MakeACS/HW-NFC-Core/README.md

# NFC Core

This is the repository for the firmware, hardware, mechanical components, and documentation of the NFC Core of the ACS hardware. 

This is also the centralized repository for hardware, firmware, and documentation used by other variants of the Core, such as the [RFID Core](https://github.com/MakeACS/HW-RFID-Core). 

## License
This project is licensed under the CERN-OHL-S 2.0 License. See LIECENSE.txt for more information.
