MakeACS/HW-NFC-Core/Mechanical/README.md

# Mechanical

This section of the repository contains 3D CAD, BOM, assembly instructions, etc. for all non-electrical hardware and mechanical components. 

Autodesk Fusion .f3z files will contain the most recent work, with outjob files (STEP, STL, BOM, etc.) being generated on major releases.
