MakeACS/HW-NFC-Core/Hardware/README.md

# Hardware

This section of the repository contains information relating to component-level electrical hardware. 

In-progress work can be found in the EasyEDA Pro .eprj2 files, with outjob files (PDF schematic, Gerber, BOM, etc.) being generated for the most recent version.
