MakeACS/HW-NFC-Core/Documentation/.Overview.md

# NFC Core Documentation

This is the documentation for the NFC Core. This cocumentation is meant to be used for technical development and construction of the device, and may not be pertinent to end-users.
