MakeACS/HW-NFC-Core/Documentation/docs/For Developers/Firmware/index.md

# Firmware Overview

Firmware for the MakeACS Core is written in C++ with usage of the Arduino Framework for ease-of-reading and ease-of-modification by users with minimal coding experience. 

Firmware is developed and compiled in the [PIOArduino](https://github.com/pioarduino) environment, to allow for hardware variants and build-on-deploy in GitHub Actions.
