MakeACS/HW-NFC-Core/Hardware/Outjob/BOM_V3.1.0 NFC Card Reader Core_NFC Card Reader PCB_2026-11-07.xlsx

No. | Quantity | Device | Designator | Footprint | Value | Manufacturer Part | Manufacturer | Supplier Part | Supplier | LCSC Price | JLCPCB Part Class
1 | 1 | MLT-8540 | BZR1 | BUZ-SMD_4P-L8.5-W8.5-P8.50-TL | 2.7kHz | MLT-8540 | 华能 | C95300 | LCSC |  | Extended Part
2 | 2 | CL10C120JB8NNNC | C1,C7 | C0603 | 12pF | CL10C120JB8NNNC | SAMSUNG(三星) | C38523 | LCSC |  | Basic Part
3 | 2 | CL10B474KA8NNNC | C2,C4 | C0603 | 470nF | CL10B474KA8NNNC | SAMSUNG(三星) | C1623 | LCSC |  | Basic Part
4 | 41 | CC0603KRX7R9BB104 | C3,C6,C8,C13,C14,C15,C16,C23,C24,C26,C27,C31,C32,C33,C34,C35,C36,C39,C40,C43,C44,C53,C59,C64,C71,C73,C74,C76,C77,C78,C79,C80,C81,C93,C94,C95,C96,C97,C98,C102,C104 | C0603 | 100nF | CC0603KRX7R9BB104 | YAGEO(国巨) | C14663 | LCSC |  | Basic Part
5 | 6 | CL10A105KB8NNNC | C5,C22,C29,C60,C90,C101 | C0603 | 1uF | CL10A105KB8NNNC | SAMSUNG(三星) | C15849 | LCSC |  | Basic Part
6 | 2 | CL10B102KB8NNNC | C9,C20 | C0603 | 1nF | CL10B102KB8NNNC | SAMSUNG(三星) | C1588 | LCSC |  | Basic Part
7 | 2 | CL10C680JB8NNNC | C10,C19 | C0603 | 68pF | CL10C680JB8NNNC | SAMSUNG(三星) | C28262 | LCSC |  | Extended Part
8 | 4 | CL10C121JB8NNNC | C11,C12,C17,C18 | C0603 | 120pF | CL10C121JB8NNNC | SAMSUNG(三星) | C18438 | LCSC |  | Extended Part
9 | 4 | CL31A476MPHNNNE | C21,C41,C42,C55 | C1206 | 47uF | CL31A476MPHNNNE | SAMSUNG(三星) | C96123 | LCSC |  | Basic Part
10 | 4 | 0603B103K500NT | C25,C85,C87,C89 | C0603 | 10nF | 0603B103K500NT | FH(风华) | C57112 | LCSC |  | Basic Part
11 | 29 | CL10A106MA8NRNC | C28,C30,C37,C38,C45,C46,C47,C48,C49,C51,C52,C54,C56,C57,C61,C62,C63,C65,C66,C67,C68,C69,C72,C75,C91,C92,C99,C100,C103 | C0603 | 10uF | CL10A106MA8NRNC | SAMSUNG(三星) | C96446 | LCSC |  | Basic Part
12 | 1 | 0603CG300J500NT | C50 | C0603 | 30pF | 0603CG300J500NT | FH(风华) | C1658 | LCSC
13 | 2 | CL10B333KB8NNNC | C58,C70 | C0603 | 33nF | CL10B333KB8NNNC | SAMSUNG(三星) | C21117 | LCSC
14 | 2 | CL10C180JB8NNNC | C82,C88 | C0603 | 18pF | CL10C180JB8NNNC | SAMSUNG(三星) | C1647 | LCSC |  | Basic Part
15 | 2 | 0603B682K500NT | C83,C84 | C0603 | 6.8nF | 0603B682K500NT | FH(风华) | C1631 | LCSC |  | Basic Part
16 | 1 | CL10A475KO8NNNC | C86 | C0603 | 4.7uF | CL10A475KO8NNNC | SAMSUNG(三星) | C19666 | LCSC |  | Basic Part
17 | 1 | HC-GAP-ACF012-1T | CN2 | USB-C-SMD_HC-GAP-ACF012-1T-1 |  | HC-GAP-ACF012-1T | HCTL(华灿天禄) | C2894906 | LCSC
18 | 1 | DS1038-15FBNSiA74-0CC | CN3 | DSUB-TH_DS1038-15FBNSIA74-0CC |  | DS1038-15FBNSiA74-0CC | CONNFLY | C75754 | LCSC |  | Extended Part
19 | 1 | HC913129AE-907-A | CN4 | RJ45-TH_HC911102A-904-A |  | HC913129AE-907-A | HCTL(华灿天禄) | C5341218 | LCSC |  | Extended Part
20 | 3 | SRV05-4_C558418 | D1,D5,D9 | SOT-23-6_L2.9-W1.6-P0.95-LS2.8-BL |  | SRV05-4 | TECH PUBLIC(台舟) | C558418 | LCSC |  | Extended Part
21 | 1 | SMFJ12A | D2 | SOD-123F_L2.8-W1.8-LS3.7-RD |  | SMFJ12A | RUILON(瑞隆源) | C82280 | LCSC
22 | 3 | B5819W SL | D6,D7,D8 | SOD-123_L2.7-W1.6-LS3.7-RD-1 |  | B5819W SL | CJ(江苏长电/长晶) | C8598 | LCSC
23 | 3 | nSMD050-33V | F1,F2,F3 | F1206 |  | nSMD050-33V | 台湾陆海 | C70077 | LCSC |  | Extended Part
24 | 3 | JK-nSMD100-16_C369161 | F4,F5,F6 | F1206 |  | JK-nSMD100-16 | JK(金科) | C369161 | LCSC
25 | 2 | MH2029-300Y | FB1,FB2 | L0805 |  | MH2029-300Y | BOURNS | C840593 | LCSC |  | Extended Part
26 | 1 | DS1023-1x5SF11 | H1 | HDR-TH_5P-P2.54-V-F-B |  | DS1023-1x5SF11 | CONNFLY | C7509517 | LCSC |  | Extended Part
27 | 2 | MLP1608VR47DT0S1 | L1,L2 | L0603 | 470nH | MLP1608VR47DT0S1 | TDK | C105533 | LCSC
28 | 2 | PSPMAA0605H-4R7M-ANP | L3,L4 | IND-SMD_L7.1-W6.6 | 4.7uH | PSPMAA0605H-4R7M-ANP | PROD(谱罗德) | C2983090 | LCSC |  | Extended Part
29 | 1 | KT-0603R | LED1 | LED0603-RD |  | KT-0603R | KENTO | C2286 | LCSC
30 | 2 | WS2812D-F8 | LED2,LED3 | LED-TH_WS2812D-F8 |  | WS2812D-F8 | worldsemi | C139126 | LCSC
31 | 4 | SMTSO30100CTJ | M6,M7,M8,M9 | SCREW-SMD_BD5.6-D4.1-H10 |  | SMTSO30100CTJ | Sinhoo(雄和远景) | C2916370 | LCSC |  | Extended Part
32 | 4 | AO3400A | Q1,Q2,Q3,Q4 | SOT-23-3_L2.9-W1.6-P1.90-LS2.8-BR |  | AO3400A | AOS | C20917 | LCSC |  | Basic Part
33 | 22 | 0603WAF1002T5E | R1,R2,R19,R20,R21,R22,R25,R26,R27,R28,R30,R31,R35,R37,R40,R52,R53,R61,R62,R63,R65,R66 | R0603 | 10kΩ | 0603WAF1002T5E | UNI-ROYAL(厚声) | C25804 | LCSC |  | Basic Part
34 | 10 | 0603WAF1001T5E | R3,R10,R14,R24,R34,R42,R44,R47,R55,R64 | R0603 | 1kΩ | 0603WAF1001T5E | UNI-ROYAL(厚声) | C21190 | LCSC |  | Basic Part
35 | 7 | 0603WAF2202T5E | R4,R9,R29,R32,R33,R57,R58 | R0603 | 22kΩ | 0603WAF2202T5E | UNI-ROYAL(厚声) | C31850 | LCSC
36 | 2 | 0603WAF1003T5E | R5,R6 | R0603 | 100kΩ | 0603WAF1003T5E | UNI-ROYAL(厚声) | C25803 | LCSC |  | Basic Part
37 | 2 | 0603WAF510KT5E | R7,R8 | R0603 | 5.1Ω | 0603WAF510KT5E | UNI-ROYAL(厚声) | C25197 | LCSC |  | Basic Part
38 | 4 | 0805W8F100JT5E | R11,R23,R48,R49 | R0805_NEW | 10Ω | 0805W8F100JT5E | UNI-ROYAL(厚声) | C17415 | LCSC |  | Basic Part
39 | 2 | 0603WAF5101T5E | R12,R13 | R0603 | 5.1kΩ | 0603WAF5101T5E | UNI-ROYAL(厚声) | C23186 | LCSC
40 | 9 | 0603WAF4701T5E | R15,R16,R17,R18,R50,R51,R56,R59,R60 | R0603 | 4.7kΩ | 0603WAF4701T5E | UNI-ROYAL(厚声) | C23162 | LCSC |  | Basic Part
41 | 1 | RTT031242FTP | R36 | R0603 | 12.4kΩ | RTT031242FTP | RALEC(旺诠) | C103261 | LCSC |  | Extended Part
42 | 4 | RC0603DR-0749R9L | R38,R39,R45,R46 | R0603 | 49.9Ω | 0603WAF1002T5E | UNI-ROYAL(厚声) | C859049 | LCSC |  | Extended Part
43 | 1 | 0603WAF100JT5E | R41 | R0603 | 10Ω | 0603WAF100JT5E | UNI-ROYAL(厚声) | C22859 | LCSC |  | Basic Part
44 | 1 | 0603WAF1004T5E | R43 | R0603 | 1MΩ | 0603WAF1004T5E | UNI-ROYAL(厚声) | C22935 | LCSC |  | Basic Part
45 | 1 | 0603WAF750JT5E | R54 | R0603 | 75Ω | 0603WAF750JT5E | UNI-ROYAL(厚声) | C4275 | LCSC
46 | 2 | K9-1267F | SW1,SW2 | SW-TH_K9-1267F |  | K9-1267F | 韩国韩荣 | C107263 | LCSC |  | Extended Part
47 | 1 | TS-1045-A13B3-D2 | SW3 | SW-SMD_L7.5-W8.0-P4.50_TS-1045-A13B3-D2 |  | TS-1045-A13B3-D2 | Yuandi(元迪) | C557898 | LCSC |  | Extended Part
48 | 1 | MFRC63003HNE | U1 | HVQFN-32_L5.0-W5.0-P0.50-TL-EP3.1 |  | MFRC63003HNE | NXP(恩智浦) | C1526298 | LCSC |  | Extended Part
49 | 3 | SN74LVC1G17DBVR | U2,U3,U4 | SOT-23-5_L3.0-W1.7-P0.95-LS2.8-BR |  | SN74LVC1G17DBVR | TI(德州仪器) | C7836 | LCSC |  | Extended Part
50 | 1 | TMP112AIDRLR | U5 | SOT-563_L1.6-W1.2-P0.50-LS1.6-BR |  | TMP112AIDRLR | TI(德州仪器) | C28927 | LCSC |  | Extended Part
51 | 1 | LIS2DH12TR | U6 | LGA-12_L2.0-W2.0-P0.50-BL |  | LIS2DH12TR | ST(意法半导体) | C110926 | LCSC
52 | 2 | MX66100T | U7,U14 | SOT-23-6_L2.9-W1.6-P0.95-LS2.9-BL |  | MX66100T | Wuxi Maxinmicro(无锡明芯微) | C53121238 | LCSC |  | Extended Part
53 | 7 | SN74LXC1T45DBVR | U8,U9,U10,U11,U12,U20,U22 | SOT-23-6_L2.9-W1.6-P0.95-LS2.8-BL |  | SN74LXC1T45DBVR | TI(德州仪器) | C4364198 | LCSC |  | Extended Part
54 | 2 | TPS62933DRLR | U13,U15 | SOT-583-8_L2.1-W1.2-P0.50-LS1.6-BR |  | TPS62933DRLR | TI(德州仪器) | C3200405 | LCSC
55 | 1 | SN74AHC1G125DBVR | U16 | SOT-23-5_L3.0-W1.7-P0.95-LS2.8-BR |  | SN74AHC1G125DBVR | TI(德州仪器) | C7468 | LCSC |  | Extended Part
56 | 1 | W5500 | U17 | LQFP-48_L7.0-W7.0-P0.50-LS9.0-BL |  | W5500 | WIZNET | C32843 | LCSC |  | Extended Part
57 | 1 | ESP32-S3-MINI-1-N8 | U18 | BULETM-SMD_ESP32-S3-MINI-1-N8 | 2.4GHz | ESP32-S3-MINI-1-N8 | ESPRESSIF(乐鑫) | C2913206 | LCSC
58 | 1 | SN74LVC1T45DBVR | U19 | SOT-23-6_L2.9-W1.6-P0.95-LS2.8-BR |  | SN74LVC1T45DBVR | TI(德州仪器) | C7843 | LCSC
59 | 1 | THVD1424RGTR | U21 | VQFN-16_L3.0-W3.0-P0.50-TL-EP1.7 |  | THVD1424RGTR | TI(德州仪器) | C5359161 | LCSC |  | Extended Part
60 | 1 | X32252712MMB4SI | X1 | CRYSTAL-SMD_4P-L3.2-W2.5-BL-1 | 27.12MHz | X32252712MMB4SI | YXC(扬兴晶振) | C29975 | LCSC |  | Extended Part
61 | 1 | X322525MOB4SI | X2 | CRYSTAL-SMD_4P-L3.2-W2.5-BL | 25MHz | X322525MOB4SI | YXC(扬兴晶振) | C9006 | LCSC |  | Basic Part
