MakeACS/HW-NFC-Core/Firmware/build_output.txt

Processing esp32-s3-devkitm-1 (platform: https://github.com/pioarduino/platform-espressif32/releases/download/stable/platform-espressif32.zip; board: esp32-s3-devkitm-1; framework: arduino)
--------------------------------------------------------------------------------
Verbose mode can be enabled via `-v, --verbose` option
CONFIGURATION: https://docs.platformio.org/page/boards/espressif32/esp32-s3-devkitm-1.html
PLATFORM: Espressif 32 (55.3.311) > Espressif ESP32-S3-DevKitM-1
HARDWARE: ESP32S3 240MHz, 320KB RAM, 8MB Flash
DEBUG: Current (esp-builtin) On-board (esp-builtin) External (cmsis-dap, esp-bridge, esp-prog, esp-prog-2, iot-bus-jtag, jlink, minimodule, olimex-arm-usb-ocd, olimex-arm-usb-ocd-h, olimex-arm-usb-tiny-h, olimex-jtag-tiny, tumpa)
PACKAGES: 
 - contrib-piohome @ 3.4.4 
 - framework-arduinoespressif32 @ 3.3.11 
 - framework-arduinoespressif32-libs @ 5.5.5+sha.b774170ff46 
 - tool-esptoolpy @ 5.3.0 
 - tool-xtensa-esp-elf-gdb @ 17.1.0+20260402 
 - toolchain-xtensa-esp-elf @ 14.2.0+20260121
LDF: Library Dependency Finder -> https://bit.ly/configure-pio-ldf
LDF Modes: Finder ~ chain, Compatibility ~ soft
Found 56 compatible libraries
Scanning dependencies...
Dependency Graph
|-- OneWire @ 2.3.8
|-- ArduinoJson @ 7.4.3
|-- WebSockets @ 2.7.3
|-- ESP32Ping @ 1.7.0
|-- MQTTPubSubClient @ 0.3.2
|-- Adafruit NeoPixel @ 1.15.5
|-- SparkFun LIS2DH12 Arduino Library @ 1.0.3
|-- MFRC630 @ 0.0.0+20260815131936.sha.577b043
|-- ESP32Time @ 2.0.6
|-- FS @ 3.3.11
|-- HTTPClient @ 3.3.11
|-- Preferences @ 3.3.11
|-- SPI @ 3.3.11
|-- SPIFFS @ 3.3.11
|-- Update @ 3.3.11
|-- WiFi @ 3.3.11
|-- NetworkClientSecure @ 3.3.11
|-- Wire @ 3.3.11
|-- ESP32OTAPullSecure
Building in release mode
Compiling .pio\build\esp32-s3-devkitm-1\lib8f3\OneWire\OneWire.cpp.o
Compiling .pio\build\esp32-s3-devkitm-1\lib895\Network\NetworkClient.cpp.o
Compiling .pio\build\esp32-s3-devkitm-1\lib895\Network\NetworkEvents.cpp.o
Compiling .pio\build\esp32-s3-devkitm-1\lib895\Network\NetworkInterface.cpp.o
Compiling .pio\build\esp32-s3-devkitm-1\lib895\Network\NetworkManager.cpp.o
Compiling .pio\build\esp32-s3-devkitm-1\lib895\Network\NetworkServer.cpp.o
Compiling .pio\build\esp32-s3-devkitm-1\lib895\Network\NetworkUdp.cpp.o
Compiling .pio\build\esp32-s3-devkitm-1\lib3db\SPI\SPI.cpp.o
Compiling .pio\build\esp32-s3-devkitm-1\libfcb\Ethernet\ETH.cpp.o
Compiling .pio\build\esp32-s3-devkitm-1\lib93d\WiFi\AP.cpp.o
Compiling .pio\build\esp32-s3-devkitm-1\lib93d\WiFi\STA.cpp.o
Compiling .pio\build\esp32-s3-devkitm-1\lib93d\WiFi\WiFi.cpp.o
platformio.exe : .pio/libdeps/esp32-s3-devkitm-1/OneWire/OneWire.cpp:599:22: 
warning: extra tokens at end of #undef directive
At line:1 char:1
+ & "C:\Users\Jim\.platformio\penv\Scripts\platformio.exe" run > build_ ...
+ ~~~~~~~~~~~~~~~~~~~~~~~~~~~~~~~~~~~~~~~~~~~~~~~~~~~~~~~~~~~~~~~~~~~~~
    + CategoryInfo          : NotSpecified: (.pio/libdeps/es...undef directive 
   :String) [], RemoteException
    + FullyQualifiedErrorId : NativeCommandError
 
  599 | #  undef noInterrupts() {portMUX_TYPE mux = 
portMUX_INITIALIZER_UNLOCKED;portENTER_CRITICAL(&mux)
      |                      ^
.pio/libdeps/esp32-s3-devkitm-1/OneWire/OneWire.cpp:600:20: warning: extra 
tokens at end of #undef directive
  600 | #  undef interrupts() portEXIT_CRITICAL(&mux);}
      |                    ^
Compiling .pio\build\esp32-s3-devkitm-1\lib93d\WiFi\WiFiAP.cpp.o
Compiling .pio\build\esp32-s3-devkitm-1\lib93d\WiFi\WiFiGeneric.cpp.o
Compiling .pio\build\esp32-s3-devkitm-1\lib93d\WiFi\WiFiMulti.cpp.o
Compiling .pio\build\esp32-s3-devkitm-1\lib93d\WiFi\WiFiSTA.cpp.o
Compiling .pio\build\esp32-s3-devkitm-1\lib93d\WiFi\WiFiScan.cpp.o
Compiling .pio\build\esp32-s3-devkitm-1\libb79\NetworkClientSecure\NetworkClientSecure.cpp.o
Compiling .pio\build\esp32-s3-devkitm-1\libb79\NetworkClientSecure\ssl_client.cpp.o
Compiling .pio\build\esp32-s3-devkitm-1\lib9f8\WebSockets\SocketIOclient.cpp.o
Compiling .pio\build\esp32-s3-devkitm-1\lib9f8\WebSockets\WebSockets.cpp.o
Compiling .pio\build\esp32-s3-devkitm-1\lib9f8\WebSockets\WebSocketsClient.cpp.o
Compiling .pio\build\esp32-s3-devkitm-1\lib9f8\WebSockets\WebSocketsServer.cpp.o
Compiling .pio\build\esp32-s3-devkitm-1\lib9f8\WebSockets\libb64\cdecode.c.o
Compiling .pio\build\esp32-s3-devkitm-1\lib9f8\WebSockets\libb64\cencode.c.o
Compiling .pio\build\esp32-s3-devkitm-1\lib9f8\WebSockets\libsha1\libsha1.c.o
Compiling .pio\build\esp32-s3-devkitm-1\lib2e3\ESP32Ping\ESP32Ping.cpp.o
Compiling .pio\build\esp32-s3-devkitm-1\lib2e3\ESP32Ping\ping.cpp.o
Compiling .pio\build\esp32-s3-devkitm-1\lib079\MQTTPubSubClient\MQTTPubSubClient\lwmqtt\client.c.o
Compiling .pio\build\esp32-s3-devkitm-1\lib079\MQTTPubSubClient\MQTTPubSubClient\lwmqtt\helpers.c.o
Compiling .pio\build\esp32-s3-devkitm-1\lib079\MQTTPubSubClient\MQTTPubSubClient\lwmqtt\packet.c.o
Compiling .pio\build\esp32-s3-devkitm-1\lib079\MQTTPubSubClient\MQTTPubSubClient\lwmqtt\string.c.o
Compiling .pio\build\esp32-s3-devkitm-1\libb3f\Adafruit NeoPixel\Adafruit_NeoPixel.cpp.o
Compiling .pio\build\esp32-s3-devkitm-1\libb3f\Adafruit NeoPixel\Adafruit_Neopixel_RP2.cpp.o
Compiling .pio\build\esp32-s3-devkitm-1\libb3f\Adafruit NeoPixel\esp.c.o
Compiling .pio\build\esp32-s3-devkitm-1\libb3f\Adafruit NeoPixel\esp8266.c.o
Compiling .pio\build\esp32-s3-devkitm-1\libb3f\Adafruit NeoPixel\kendyte_k210.c.o
Compiling .pio\build\esp32-s3-devkitm-1\libb3f\Adafruit NeoPixel\psoc6.c.o
Compiling .pio\build\esp32-s3-devkitm-1\lib99b\Wire\Wire.cpp.o
Compiling .pio\build\esp32-s3-devkitm-1\libd86\SparkFun LIS2DH12 Arduino Library\SparkFun_LIS2DH12.cpp.o
Compiling .pio\build\esp32-s3-devkitm-1\libd86\SparkFun LIS2DH12 Arduino Library\lis2dh12_reg.cpp.o
Compiling .pio\build\esp32-s3-devkitm-1\lib93e\MFRC630\mfrc630.c.o
Compiling .pio\build\esp32-s3-devkitm-1\lib666\ESP32Time\ESP32Time.cpp.o
Compiling .pio\build\esp32-s3-devkitm-1\libfa4\FS\FS.cpp.o
Compiling .pio\build\esp32-s3-devkitm-1\libfa4\FS\vfs_api.cpp.o
Compiling .pio\build\esp32-s3-devkitm-1\lib588\HTTPClient\HTTPClient.cpp.o
Compiling .pio\build\esp32-s3-devkitm-1\lib68a\Preferences\Preferences.cpp.o
Compiling .pio\build\esp32-s3-devkitm-1\libe3a\SPIFFS\SPIFFS.cpp.o
Compiling .pio\build\esp32-s3-devkitm-1\lib681\Hash\PBKDF2_HMACBuilder.cpp.o
Compiling .pio\build\esp32-s3-devkitm-1\lib681\Hash\SHA1Builder.cpp.o
Compiling .pio\build\esp32-s3-devkitm-1\lib681\Hash\SHA2Builder.cpp.o
Compiling .pio\build\esp32-s3-devkitm-1\lib681\Hash\SHA3Builder.cpp.o
Compiling .pio\build\esp32-s3-devkitm-1\lib79a\Update\HttpsOTAUpdate.cpp.o
Compiling .pio\build\esp32-s3-devkitm-1\lib79a\Update\Updater.cpp.o
Compiling .pio\build\esp32-s3-devkitm-1\lib79a\Update\Updater_Signing.cpp.o
Compiling .pio\build\esp32-s3-devkitm-1\src\AudioVisualController.cpp.o
Compiling .pio\build\esp32-s3-devkitm-1\src\BusMonitor.cpp.o
Compiling .pio\build\esp32-s3-devkitm-1\src\DisplayController.cpp.o
Compiling .pio\build\esp32-s3-devkitm-1\src\MachineStateController.cpp.o
Compiling .pio\build\esp32-s3-devkitm-1\src\MainController.cpp.o
Building .pio\build\esp32-s3-devkitm-1\bootloader.bin
Generating partitions .pio\build\esp32-s3-devkitm-1\partitions.bin
esptool v5.3.0
Creating ESP32-S3 image...
Merged 2 ELF sections.
Successfully created ESP32-S3 image.
Compiling .pio\build\esp32-s3-devkitm-1\FrameworkArduino\ColorFormat.c.o
Compiling .pio\build\esp32-s3-devkitm-1\FrameworkArduino\Esp.cpp.o
Compiling .pio\build\esp32-s3-devkitm-1\FrameworkArduino\FirmwareMSC.cpp.o
Compiling .pio\build\esp32-s3-devkitm-1\FrameworkArduino\FunctionalInterrupt.cpp.o
Compiling .pio\build\esp32-s3-devkitm-1\FrameworkArduino\HEXBuilder.cpp.o
Compiling .pio\build\esp32-s3-devkitm-1\FrameworkArduino\HWCDC.cpp.o
Compiling .pio\build\esp32-s3-devkitm-1\FrameworkArduino\HardwareSerial.cpp.o
Compiling .pio\build\esp32-s3-devkitm-1\FrameworkArduino\HashBuilder.cpp.o
Compiling .pio\build\esp32-s3-devkitm-1\FrameworkArduino\IPAddress.cpp.o
Compiling .pio\build\esp32-s3-devkitm-1\FrameworkArduino\MD5Builder.cpp.o
Compiling .pio\build\esp32-s3-devkitm-1\FrameworkArduino\MacAddress.cpp.o
Compiling .pio\build\esp32-s3-devkitm-1\FrameworkArduino\Print.cpp.o
Compiling .pio\build\esp32-s3-devkitm-1\FrameworkArduino\Stream.cpp.o
Compiling .pio\build\esp32-s3-devkitm-1\FrameworkArduino\StreamString.cpp.o
Compiling .pio\build\esp32-s3-devkitm-1\FrameworkArduino\StringUtils.cpp.o
Compiling .pio\build\esp32-s3-devkitm-1\FrameworkArduino\Tone.cpp.o
Compiling .pio\build\esp32-s3-devkitm-1\FrameworkArduino\USB.cpp.o
Compiling .pio\build\esp32-s3-devkitm-1\FrameworkArduino\USBCDC.cpp.o
Compiling .pio\build\esp32-s3-devkitm-1\FrameworkArduino\USBMSC.cpp.o
src/MainController.cpp: In function 'void loop()':
src/MainController.cpp:642:70: warning: 'ArduinoJson::V743PB22::JsonObject 
ArduinoJson::V743PB22::JsonArray::createNestedObject() const' is deprecated: 
use add<JsonObject>() instead [-Wdeprecated-declarations]
  642 |             JsonObject stateObject = 
stateChannels.createNestedObject();
      |                                      ~~~~~~~~~~~~~~~~~~~~~~~~~~~~~~~~^~
In file included from 
.pio/libdeps/esp32-s3-devkitm-1/ArduinoJson/src/ArduinoJson.hpp:65,
                 from 
.pio/libdeps/esp32-s3-devkitm-1/ArduinoJson/src/ArduinoJson.h:9,
                 from src/Globals.h:5,
                 from src/MainController.cpp:16:
.pio/libdeps/esp32-s3-devkitm-1/ArduinoJson/src/ArduinoJson/compatibility.hpp:1
40:19: note: declared here
  140 | inline JsonObject JsonArray::createNestedObject() const {
      |                   ^~~~~~~~~
src/MainController.cpp:671:68: warning: 'ArduinoJson::V743PB22::JsonObject 
ArduinoJson::V743PB22::JsonArray::createNestedObject() const' is deprecated: 
use add<JsonObject>() instead [-Wdeprecated-declarations]
  671 |         JsonObject configObject = configChannels.createNestedObject();
      |                                   ~~~~~~~~~~~~~~~~~~~~~~~~~~~~~~~~~^~
.pio/libdeps/esp32-s3-devkitm-1/ArduinoJson/src/ArduinoJson/compatibility.hpp:1
40:19: note: declared here
  140 | inline JsonObject JsonArray::createNestedObject() const {
      |                   ^~~~~~~~~
src/MainController.cpp:681:67: warning: 'ArduinoJson::V743PB22::JsonObject 
ArduinoJson::V743PB22::JsonArray::createNestedObject() const' is deprecated: 
use add<JsonObject>() instead [-Wdeprecated-declarations]
  681 |         JsonObject deviceObj = configComponents.createNestedObject();
      |                                ~~~~~~~~~~~~~~~~~~~~~~~~~~~~~~~~~~~^~
.pio/libdeps/esp32-s3-devkitm-1/ArduinoJson/src/ArduinoJson/compatibility.hpp:1
40:19: note: declared here
  140 | inline JsonObject JsonArray::createNestedObject() const {
      |                   ^~~~~~~~~
src/MainController.cpp:748:70: warning: 'ArduinoJson::V743PB22::JsonObject 
ArduinoJson::V743PB22::JsonArray::createNestedObject() const' is deprecated: 
use add<JsonObject>() instead [-Wdeprecated-declarations]
  748 |           JsonObject statusObject = 
statusChannels.createNestedObject();
      |                                     ~~~~~~~~~~~~~~~~~~~~~~~~~~~~~~~~~^~
.pio/libdeps/esp32-s3-devkitm-1/ArduinoJson/src/ArduinoJson/compatibility.hpp:1
40:19: note: declared here
  140 | inline JsonObject JsonArray::createNestedObject() const {
      |                   ^~~~~~~~~
src/MainController.cpp:861:30: warning: 'bool 
ArduinoJson::V743PB22::JsonDocument::containsKey(TChar*) const [with TChar = 
const char]' is deprecated: use doc["key"].is<T>() instead 
[-Wdeprecated-declarations]
  861 |       if(incoming.containsKey("hmi")){
      |          ~~~~~~~~~~~~~~~~~~~~^~~~~~~
In file included from 
.pio/libdeps/esp32-s3-devkitm-1/ArduinoJson/src/ArduinoJson.hpp:42:
.pio/libdeps/esp32-s3-devkitm-1/ArduinoJson/src/ArduinoJson/Document/JsonDocume
nt.hpp:167:8: note: declared here
  167 |   bool containsKey(TChar* key) const {
      |        ^~~~~~~~~~~
src/MainController.cpp:872:30: warning: 'bool 
ArduinoJson::V743PB22::JsonDocument::containsKey(TChar*) const [with TChar = 
const char]' is deprecated: use doc["key"].is<T>() instead 
[-Wdeprecated-declarations]
  872 |       if(incoming.containsKey("time")){
      |          ~~~~~~~~~~~~~~~~~~~~^~~~~~~~
.pio/libdeps/esp32-s3-devkitm-1/ArduinoJson/src/ArduinoJson/Document/JsonDocume
nt.hpp:167:8: note: declared here
  167 |   bool containsKey(TChar* key) const {
      |        ^~~~~~~~~~~
src/MainController.cpp:879:30: warning: 'bool 
ArduinoJson::V743PB22::JsonDocument::containsKey(TChar*) const [with TChar = 
const char]' is deprecated: use doc["key"].is<T>() instead 
[-Wdeprecated-declarations]
  879 |       if(incoming.containsKey("flags")){
      |          ~~~~~~~~~~~~~~~~~~~~^~~~~~~~~
.pio/libdeps/esp32-s3-devkitm-1/ArduinoJson/src/ArduinoJson/Document/JsonDocume
nt.hpp:167:8: note: declared here
  167 |   bool containsKey(TChar* key) const {
      |        ^~~~~~~~~~~
src/MainController.cpp:881:31: warning: 'bool 
ArduinoJson::V743PB22::JsonObject::containsKey(const TString&) const [with 
TString = char [13]; typename ArduinoJson::V743PB22::detail::enable_if<ArduinoJ
son::V743PB22::detail::IsString<TString>::value, int>::type <anonymous> = 0]' 
is deprecated: use obj[key].is<T>() instead [-Wdeprecated-declarations]
  881 |         if(flagObj.containsKey("lockWhenIdle")){
      |            ~~~~~~~~~~~~~~~~~~~^~~~~~~~~~~~~~~~
In file included from 
.pio/libdeps/esp32-s3-devkitm-1/ArduinoJson/src/ArduinoJson.hpp:39:
.pio/libdeps/esp32-s3-devkitm-1/ArduinoJson/src/ArduinoJson/Object/JsonObject.h
pp:168:8: note: declared here
  168 |   bool containsKey(const TString& key) const {
      |        ^~~~~~~~~~~
src/MainController.cpp:886:31: warning: 'bool 
ArduinoJson::V743PB22::JsonObject::containsKey(const TString&) const [with 
TString = char [18]; typename ArduinoJson::V743PB22::detail::enable_if<ArduinoJ
son::V743PB22::detail::IsString<TString>::value, int>::type <anonymous> = 0]' 
is deprecated: use obj[key].is<T>() instead [-Wdeprecated-declarations]
  886 |         if(flagObj.containsKey("restartWhenUnused")){
      |            ~~~~~~~~~~~~~~~~~~~^~~~~~~~~~~~~~~~~~~~~
.pio/libdeps/esp32-s3-devkitm-1/ArduinoJson/src/ArduinoJson/Object/JsonObject.h
pp:168:8: note: declared here
  168 |   bool containsKey(const TString& key) const {
      |        ^~~~~~~~~~~
src/MainController.cpp:891:31: warning: 'bool 
ArduinoJson::V743PB22::JsonObject::containsKey(const TString&) const [with 
TString = char [10]; typename ArduinoJson::V743PB22::detail::enable_if<ArduinoJ
son::V743PB22::detail::IsString<TString>::value, int>::type <anonymous> = 0]' 
is deprecated: use obj[key].is<T>() instead [-Wdeprecated-declarations]
  891 |         if(flagObj.containsKey("welcoming")){
      |            ~~~~~~~~~~~~~~~~~~~^~~~~~~~~~~~~
.pio/libdeps/esp32-s3-devkitm-1/ArduinoJson/src/ArduinoJson/Object/JsonObject.h
pp:168:8: note: declared here
  168 |   bool containsKey(const TString& key) const {
      |        ^~~~~~~~~~~
src/MainController.cpp:909:30: warning: 'bool 
ArduinoJson::V743PB22::JsonDocument::containsKey(TChar*) const [with TChar = 
const char]' is deprecated: use doc["key"].is<T>() instead 
[-Wdeprecated-declarations]
  909 |       if(incoming.containsKey("hobbsTime")){
      |          ~~~~~~~~~~~~~~~~~~~~^~~~~~~~~~~~~
.pio/libdeps/esp32-s3-devkitm-1/ArduinoJson/src/ArduinoJson/Document/JsonDocume
nt.hpp:167:8: note: declared here
  167 |   bool containsKey(TChar* key) const {
      |        ^~~~~~~~~~~
src/MainController.cpp:943:30: warning: 'bool 
ArduinoJson::V743PB22::JsonDocument::containsKey(TChar*) const [with TChar = 
const char]' is deprecated: use doc["key"].is<T>() instead 
[-Wdeprecated-declarations]
  943 |       if(incoming.containsKey("flags")){
      |          ~~~~~~~~~~~~~~~~~~~~^~~~~~~~~
.pio/libdeps/esp32-s3-devkitm-1/ArduinoJson/src/ArduinoJson/Document/JsonDocume
nt.hpp:167:8: note: declared here
  167 |   bool containsKey(TChar* key) const {
      |        ^~~~~~~~~~~
src/MainController.cpp:945:31: warning: 'bool 
ArduinoJson::V743PB22::JsonObject::containsKey(const TString&) const [with 
TString = char [13]; typename ArduinoJson::V743PB22::detail::enable_if<ArduinoJ
son::V743PB22::detail::IsString<TString>::value, int>::type <anonymous> = 0]' 
is deprecated: use obj[key].is<T>() instead [-Wdeprecated-declarations]
  945 |         if(flagObj.containsKey("lockWhenIdle")){
      |            ~~~~~~~~~~~~~~~~~~~^~~~~~~~~~~~~~~~
.pio/libdeps/esp32-s3-devkitm-1/ArduinoJson/src/ArduinoJson/Object/JsonObject.h
pp:168:8: note: declared here
  168 |   bool containsKey(const TString& key) const {
      |        ^~~~~~~~~~~
src/MainController.cpp:950:31: warning: 'bool 
ArduinoJson::V743PB22::JsonObject::containsKey(const TString&) const [with 
TString = char [18]; typename ArduinoJson::V743PB22::detail::enable_if<ArduinoJ
son::V743PB22::detail::IsString<TString>::value, int>::type <anonymous> = 0]' 
is deprecated: use obj[key].is<T>() instead [-Wdeprecated-declarations]
  950 |         if(flagObj.containsKey("restartWhenUnused")){
      |            ~~~~~~~~~~~~~~~~~~~^~~~~~~~~~~~~~~~~~~~~
.pio/libdeps/esp32-s3-devkitm-1/ArduinoJson/src/ArduinoJson/Object/JsonObject.h
pp:168:8: note: declared here
  168 |   bool containsKey(const TString& key) const {
      |        ^~~~~~~~~~~
src/MainController.cpp:955:31: warning: 'bool 
ArduinoJson::V743PB22::JsonObject::containsKey(const TString&) const [with 
TString = char [10]; typename ArduinoJson::V743PB22::detail::enable_if<ArduinoJ
son::V743PB22::detail::IsString<TString>::value, int>::type <anonymous> = 0]' 
is deprecated: use obj[key].is<T>() instead [-Wdeprecated-declarations]
  955 |         if(flagObj.containsKey("welcoming")){
      |            ~~~~~~~~~~~~~~~~~~~^~~~~~~~~~~~~
.pio/libdeps/esp32-s3-devkitm-1/ArduinoJson/src/ArduinoJson/Object/JsonObject.h
pp:168:8: note: declared here
  168 |   bool containsKey(const TString& key) const {
      |        ^~~~~~~~~~~
src/MainController.cpp:973:30: warning: 'bool 
ArduinoJson::V743PB22::JsonDocument::containsKey(TChar*) const [with TChar = 
const char]' is deprecated: use doc["key"].is<T>() instead 
[-Wdeprecated-declarations]
  973 |       if(incoming.containsKey("hobbsTime")){
      |          ~~~~~~~~~~~~~~~~~~~~^~~~~~~~~~~~~
.pio/libdeps/esp32-s3-devkitm-1/ArduinoJson/src/ArduinoJson/Document/JsonDocume
nt.hpp:167:8: note: declared here
  167 |   bool containsKey(TChar* key) const {
      |        ^~~~~~~~~~~
src/MainController.cpp:988:30: warning: 'bool 
ArduinoJson::V743PB22::JsonDocument::containsKey(TChar*) const [with TChar = 
const char]' is deprecated: use doc["key"].is<T>() instead 
[-Wdeprecated-declarations]
  988 |       if(incoming.containsKey("action")){
      |          ~~~~~~~~~~~~~~~~~~~~^~~~~~~~~~
.pio/libdeps/esp32-s3-devkitm-1/ArduinoJson/src/ArduinoJson/Document/JsonDocume
nt.hpp:167:8: note: declared here
  167 |   bool containsKey(TChar* key) const {
      |        ^~~~~~~~~~~
src/MainController.cpp: At global scope:
src/MainController.cpp:1542:44: warning: ignoring attribute 'section 
(".iram1.1")' because it conflicts with previous 'section (".iram1.0")' 
[-Wattributes]
 1542 | void IRAM_ATTR updateHobbsCounter(void* arg) {
      |                                            ^
src/Globals.h:78:16: note: previous declaration here
   78 | void IRAM_ATTR updateHobbsCounter(void* arg);
      |                ^~~~~~~~~~~~~~~~~~
Compiling .pio\build\esp32-s3-devkitm-1\FrameworkArduino\WMath.cpp.o
Compiling .pio\build\esp32-s3-devkitm-1\FrameworkArduino\WString.cpp.o
Compiling .pio\build\esp32-s3-devkitm-1\FrameworkArduino\base64.cpp.o
Compiling .pio\build\esp32-s3-devkitm-1\FrameworkArduino\cbuf.cpp.o
Compiling .pio\build\esp32-s3-devkitm-1\FrameworkArduino\chip-debug-report.cpp.o
Compiling .pio\build\esp32-s3-devkitm-1\FrameworkArduino\esp32-hal-adc.c.o
Compiling .pio\build\esp32-s3-devkitm-1\FrameworkArduino\esp32-hal-bt.c.o
Compiling .pio\build\esp32-s3-devkitm-1\FrameworkArduino\esp32-hal-cpu.c.o
Compiling .pio\build\esp32-s3-devkitm-1\FrameworkArduino\esp32-hal-dac.c.o
Compiling .pio\build\esp32-s3-devkitm-1\FrameworkArduino\esp32-hal-gpio.c.o
Compiling .pio\build\esp32-s3-devkitm-1\FrameworkArduino\esp32-hal-hosted.c.o
Compiling .pio\build\esp32-s3-devkitm-1\FrameworkArduino\esp32-hal-i2c-ng.c.o
Compiling .pio\build\esp32-s3-devkitm-1\FrameworkArduino\esp32-hal-i2c-slave.c.o
Compiling .pio\build\esp32-s3-devkitm-1\FrameworkArduino\esp32-hal-i2c.c.o
Compiling .pio\build\esp32-s3-devkitm-1\FrameworkArduino\esp32-hal-ldo.c.o
Compiling .pio\build\esp32-s3-devkitm-1\FrameworkArduino\esp32-hal-ledc.c.o
Compiling .pio\build\esp32-s3-devkitm-1\FrameworkArduino\esp32-hal-log-wrapper.c.o
Compiling .pio\build\esp32-s3-devkitm-1\FrameworkArduino\esp32-hal-matrix.c.o
Compiling .pio\build\esp32-s3-devkitm-1\FrameworkArduino\esp32-hal-misc.c.o
Compiling .pio\build\esp32-s3-devkitm-1\FrameworkArduino\esp32-hal-periman.c.o
Compiling .pio\build\esp32-s3-devkitm-1\FrameworkArduino\esp32-hal-psram.c.o
Compiling .pio\build\esp32-s3-devkitm-1\FrameworkArduino\esp32-hal-rgb-led.c.o
Compiling .pio\build\esp32-s3-devkitm-1\FrameworkArduino\esp32-hal-rmt.c.o
Compiling .pio\build\esp32-s3-devkitm-1\FrameworkArduino\esp32-hal-sigmadelta.c.o
Compiling .pio\build\esp32-s3-devkitm-1\FrameworkArduino\esp32-hal-spi.c.o
Compiling .pio\build\esp32-s3-devkitm-1\FrameworkArduino\esp32-hal-time.c.o
Compiling .pio\build\esp32-s3-devkitm-1\FrameworkArduino\esp32-hal-timer.c.o
Compiling .pio\build\esp32-s3-devkitm-1\FrameworkArduino\esp32-hal-tinyusb.c.o
Compiling .pio\build\esp32-s3-devkitm-1\FrameworkArduino\esp32-hal-touch-ng.c.o
Compiling .pio\build\esp32-s3-devkitm-1\FrameworkArduino\esp32-hal-touch.c.o
Compiling .pio\build\esp32-s3-devkitm-1\FrameworkArduino\esp32-hal-uart.c.o
Compiling .pio\build\esp32-s3-devkitm-1\FrameworkArduino\firmware_msc_fat.c.o
Compiling .pio\build\esp32-s3-devkitm-1\FrameworkArduino\freertos_stats.cpp.o
Compiling .pio\build\esp32-s3-devkitm-1\FrameworkArduino\idf_openthread_mpool_wrapper.c.o
Compiling .pio\build\esp32-s3-devkitm-1\FrameworkArduino\libb64\cdecode.c.o
Compiling .pio\build\esp32-s3-devkitm-1\FrameworkArduino\libb64\cencode.c.o
Compiling .pio\build\esp32-s3-devkitm-1\FrameworkArduino\main.cpp.o
Compiling .pio\build\esp32-s3-devkitm-1\FrameworkArduino\stdlib_noniso.c.o
Compiling .pio\build\esp32-s3-devkitm-1\FrameworkArduino\wiring_pulse.c.o
Compiling .pio\build\esp32-s3-devkitm-1\FrameworkArduino\wiring_shift.c.o
Archiving .pio\build\esp32-s3-devkitm-1\libFrameworkArduino.a
Linking .pio\build\esp32-s3-devkitm-1\firmware.elf
Firmware metrics can not be shown. Set the terminal codepage to "utf-8" or "cp65001" on Windows.
Retrieving maximum program size .pio\build\esp32-s3-devkitm-1\firmware.elf
Checking size .pio\build\esp32-s3-devkitm-1\firmware.elf
Advanced Memory Usage is available via "PlatformIO Home > Project Inspect"
RAM:   [==        ]  16.2% (used 53184 bytes from 327680 bytes)
Flash: [====      ]  38.7% (used 1294060 bytes from 3342336 bytes)
Building .pio\build\esp32-s3-devkitm-1\firmware.bin
esptool v5.3.0
Creating ESP32-S3 image...
Merged 4 ELF sections.
Successfully created ESP32-S3 image.
Creating binary "firmware.factory.bin" with:
    Offset   | File
 -  0x0000   | bootloader.bin
 -  0x8000   | partitions.bin
 -  0xe000   | boot_app0.bin
 -  0x10000  | firmware.bin
Successfully created combined binary image.
========================= [SUCCESS] Took 45.04 seconds =========================
