MakeACS/HW-NFC-Core/Documentation/docs/User Manual/Configuration.md

# Configuration

!!! info
    All configuration for the Core is done through a simple program called "ESP_Config", that can be downloaded [from GitHub here](https://github.com/JimHeaney/ESP-Config/releases/latest){target="_blank"}. This program is only compatible with Windows computers.

To begin, connect the Core to your computer with a USB cable.
