MakeACS/HW-NFC-Core/Documentation/docs/1-getting-started.md

---
icon: lucide/rocket
---

# 1. Getting Started

## 1.1 Hardware Review
