MakeACS/HW-NFC-Core/Documentation/docs/User Manual/Firmware Update.md

# Firmware Update

By default, the Core will perform an OTA (Over-The-Air) update when it boots, assuming it can connect to the network.
