MakeACS/HW-NFC-Core/Hardware/Outjob/SCH_NFC Card Reader_2026-11-07.pdf

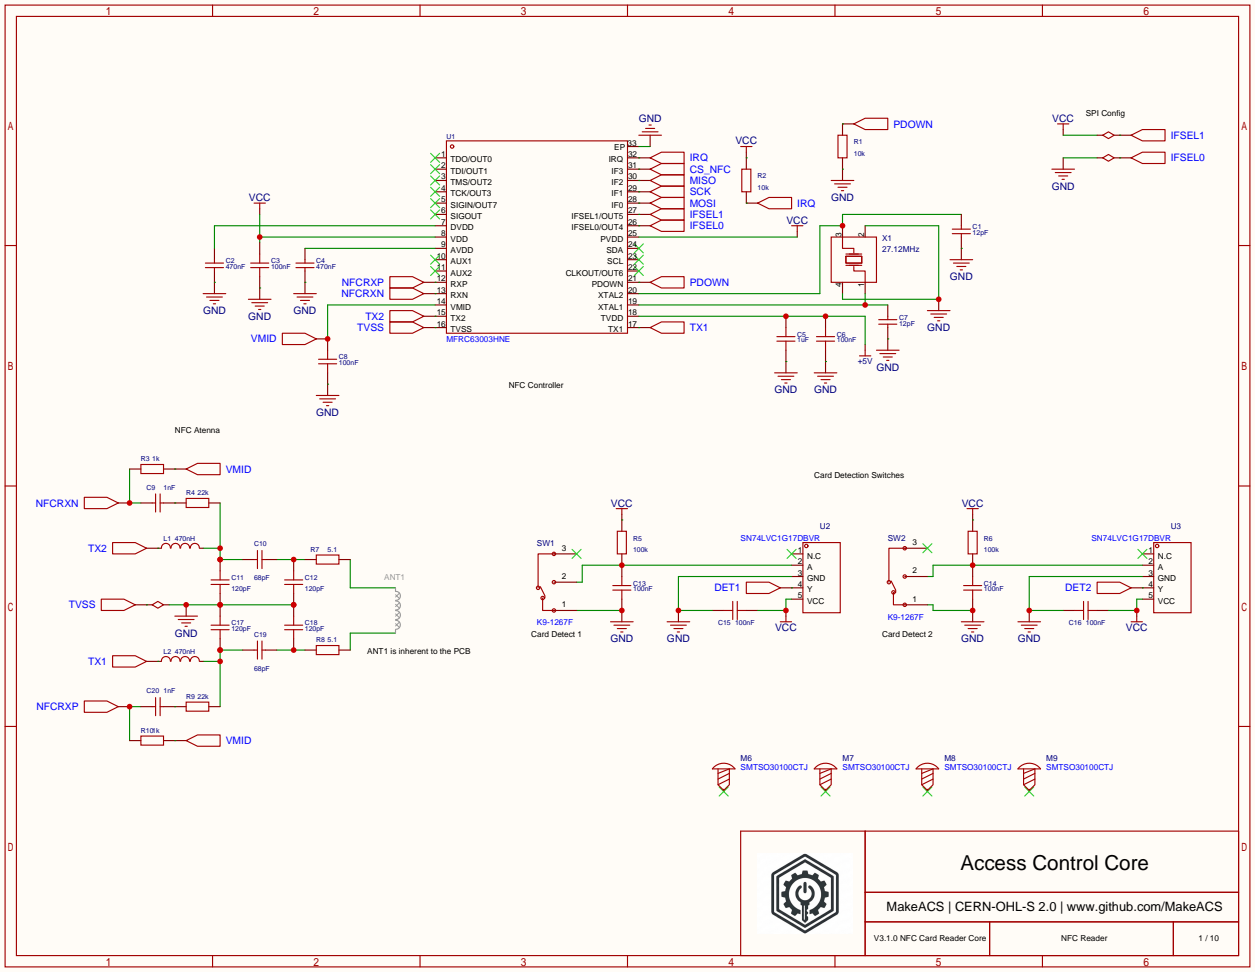
[picture p1: page 1]

ANT1 is inherent to the PCB

MakeACS | CERN-OHL-S 2.0 | www.github.com/MakeACS

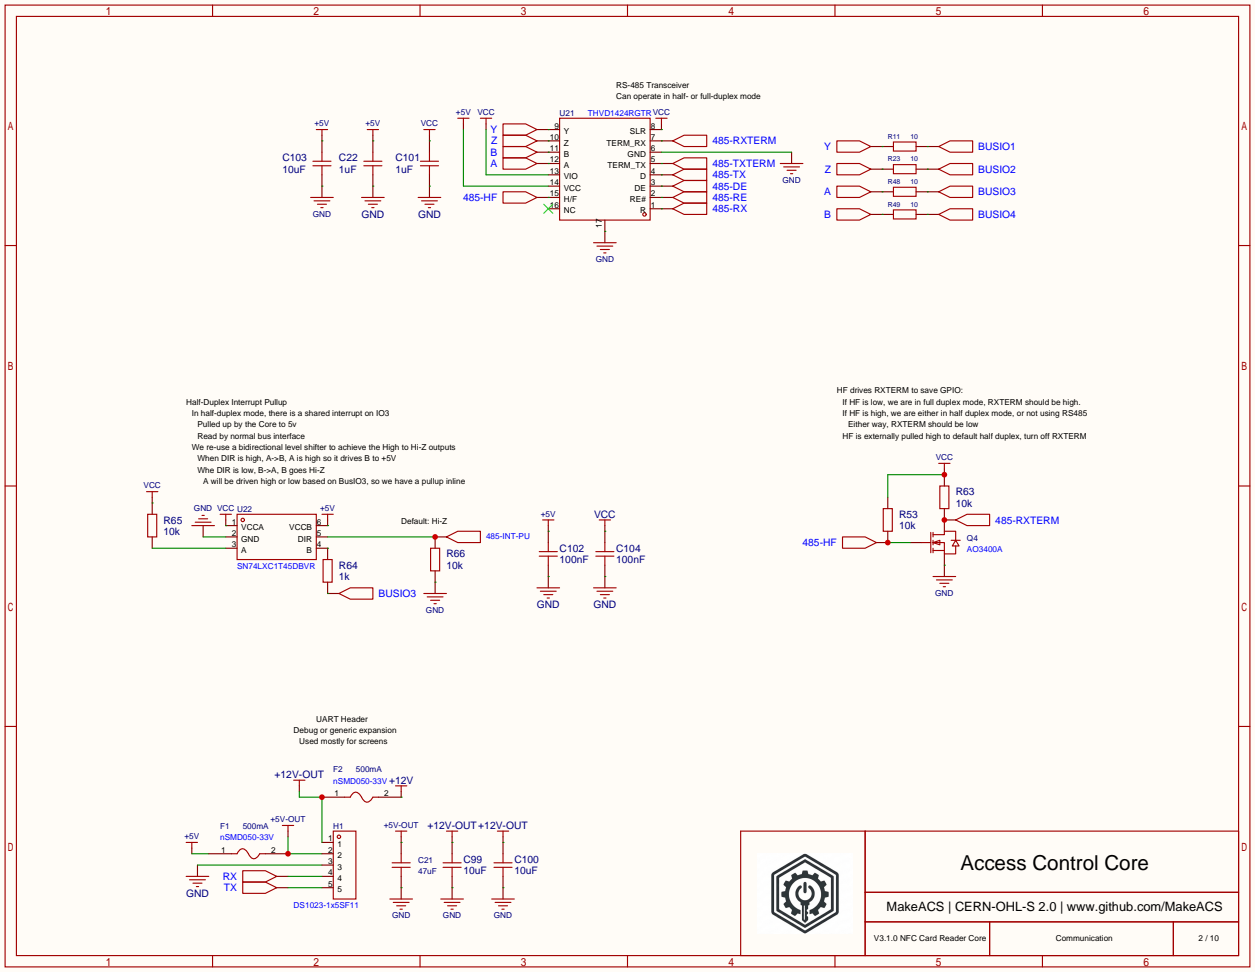
[picture p2: page 2]

RS-485 Transceiver
Can operate in half- or full-duplex mode

HF drives RXTERM to save GPIO:

In half-duplex mode, there is a shared interrupt on IO3
Pulled up by the Core to 5v
Read by normal bus interface
We re-use a bidirectional level shifter to achieve the High to Hi-Z outputs
When DIR is high, A->B, A is high so it drives B to +5V
Whe DIR is low, B->A, B goes Hi-Z
A will be driven high or low based on BusIO3, so we have a pullup inline

If HF is high, we are either in half duplex mode, or not using RS485
Either way, RXTERM should be low
HF is externally pulled high to default half duplex, turn off RXTERM

UART Header
Debug or generic expansion
Used mostly for screens

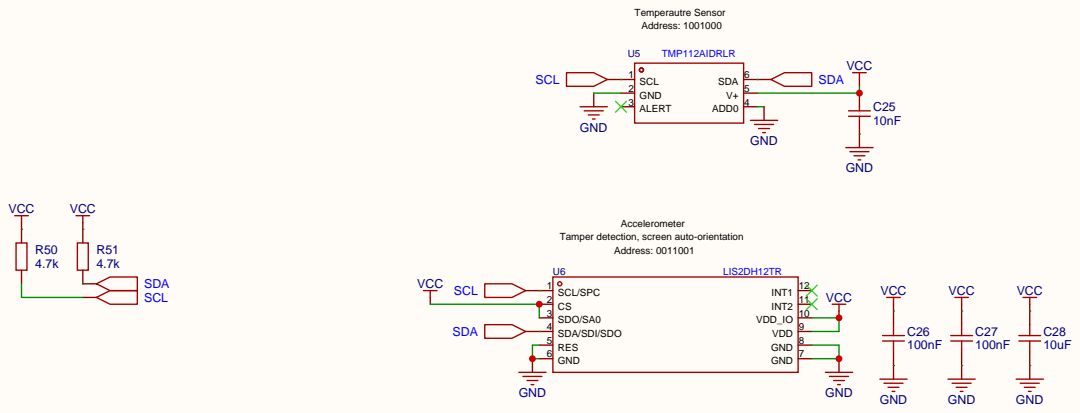
[picture p3: page 3]

Tamper detection, screen auto-orientation

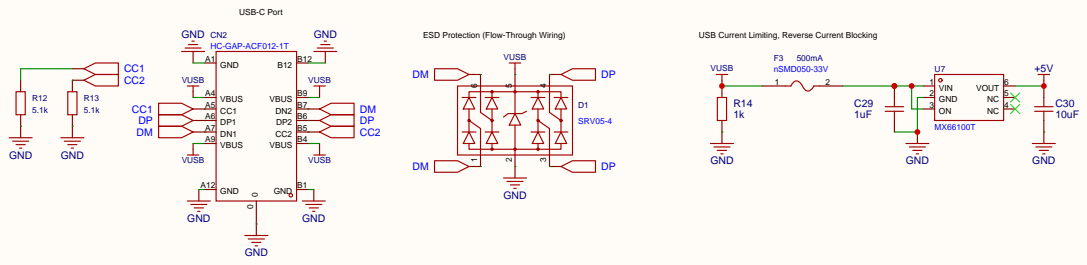
[picture p4: page 4]

ESD Protection (Flow-Through Wiring)

USB Current Limiting, Reverse Current Blocking

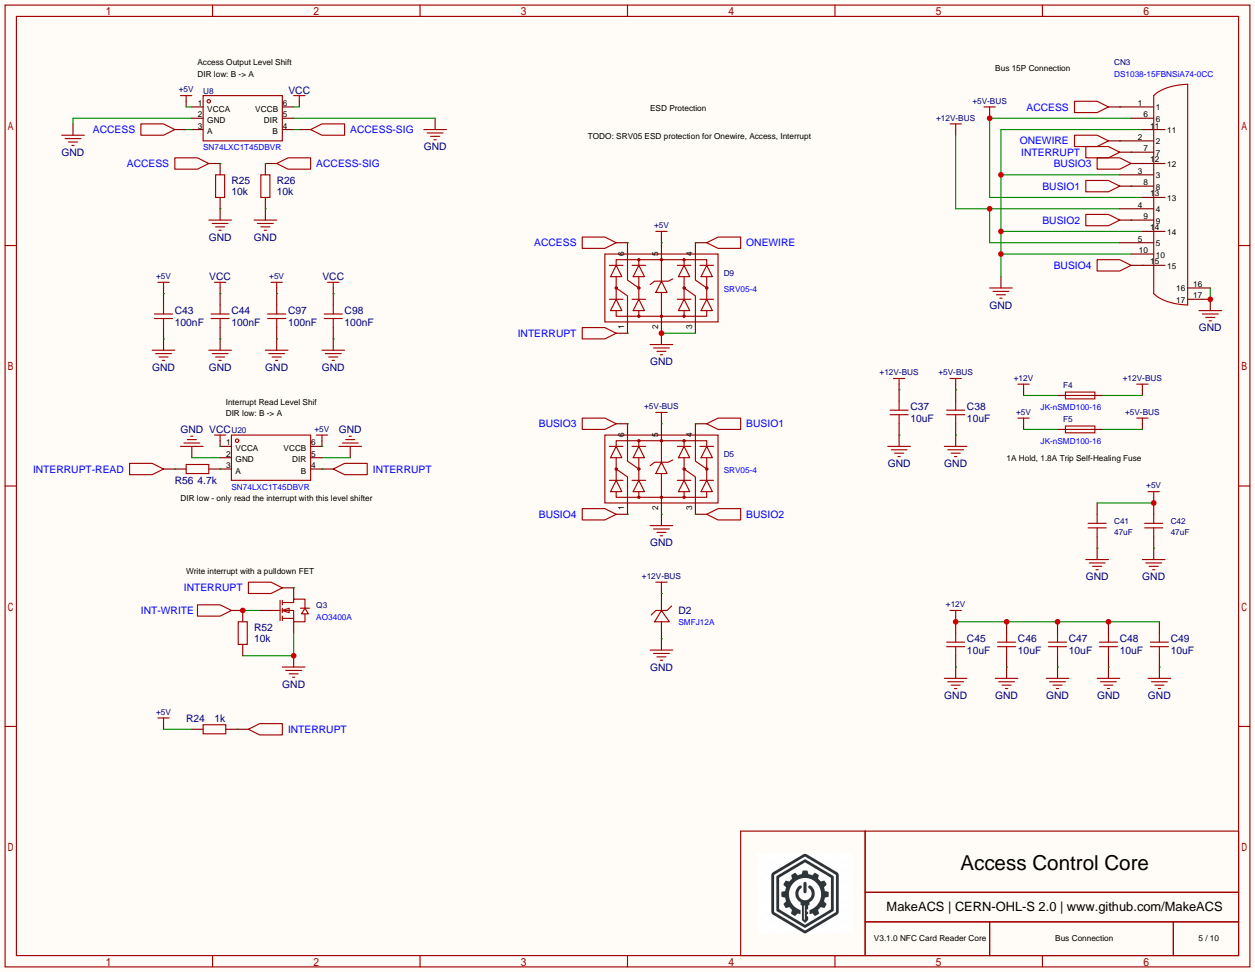
[picture p5: page 5]

TODO: SRV05 ESD protection for Onewire, Access, Interrupt

1A Hold, 1.8A Trip Self-Healing Fuse

DIR low - only read the interrupt with this level shifter

Write interrupt with a pulldown FET
INTERRUPT

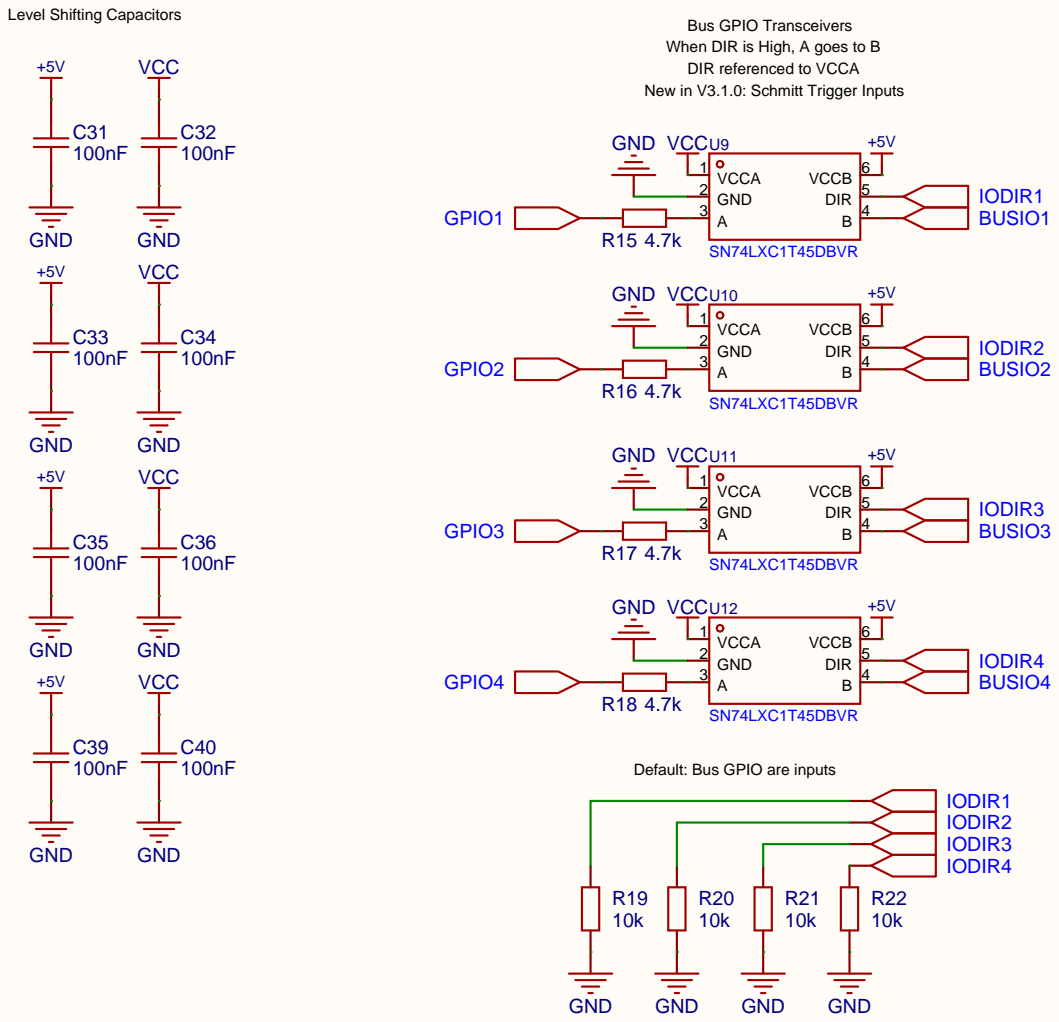
[picture p6: page 6]

Bus GPIO Transceivers
When DIR is High, A goes to B
DIR referenced to VCCA
New in V3.1.0: Schmitt Trigger Inputs

Default: Bus GPIO are inputs

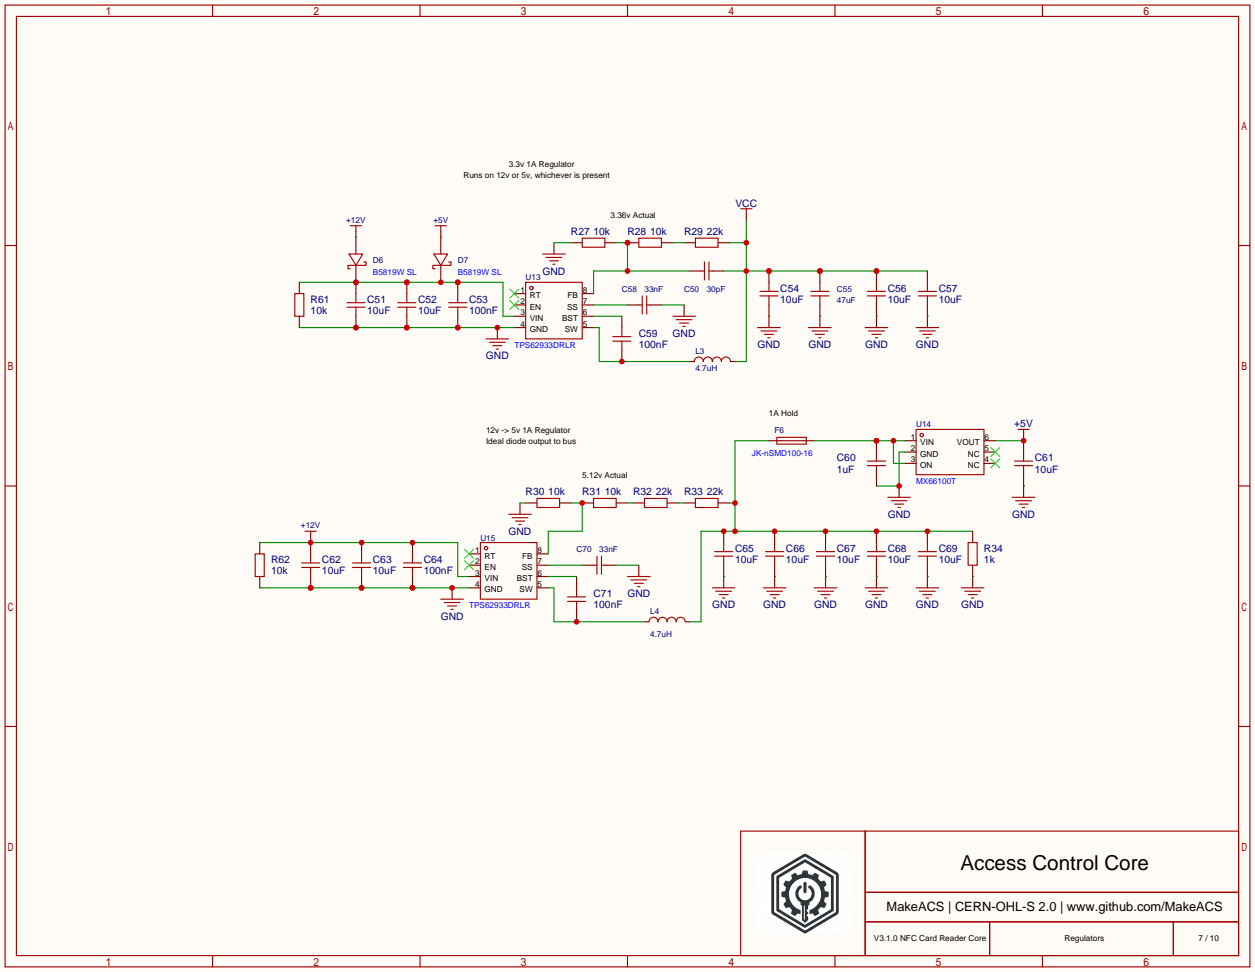
[picture p7: page 7]

Runs on 12v or 5v, whichever is present

12v -> 5v 1A Regulator
Ideal diode output to bus

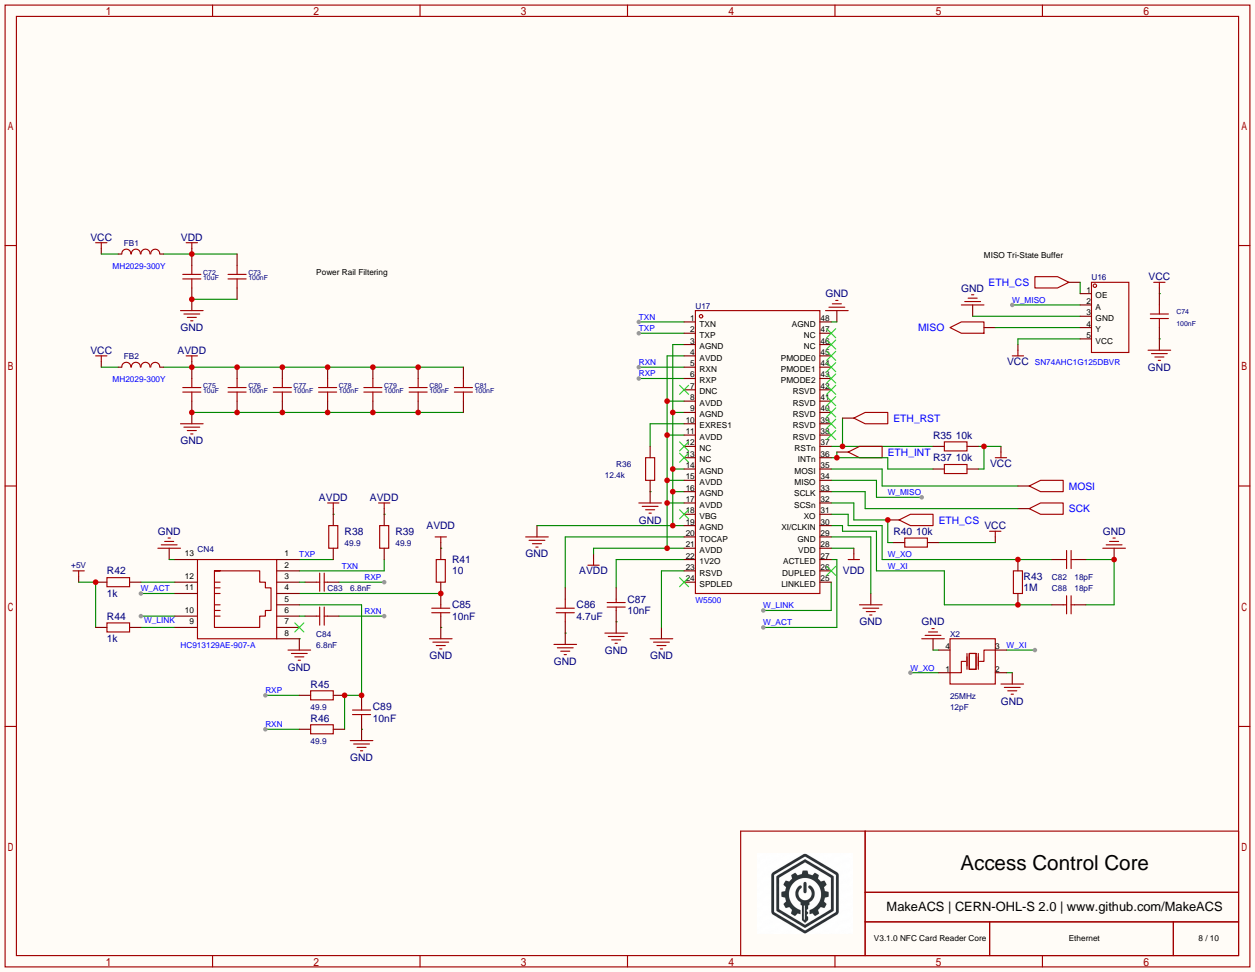
[picture p8: page 8]

MISO Tri-State Buffer

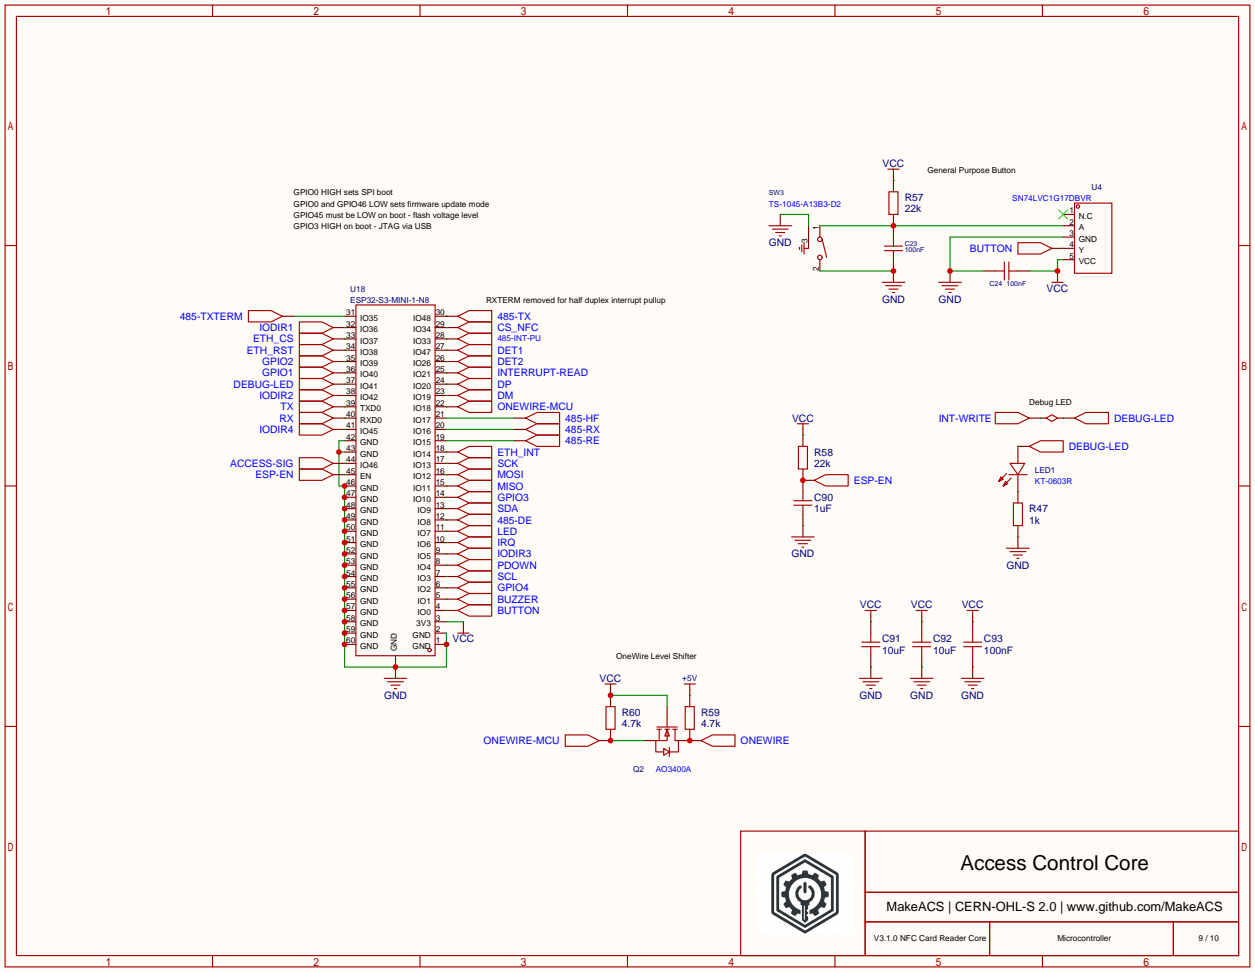
[picture p9: page 9]

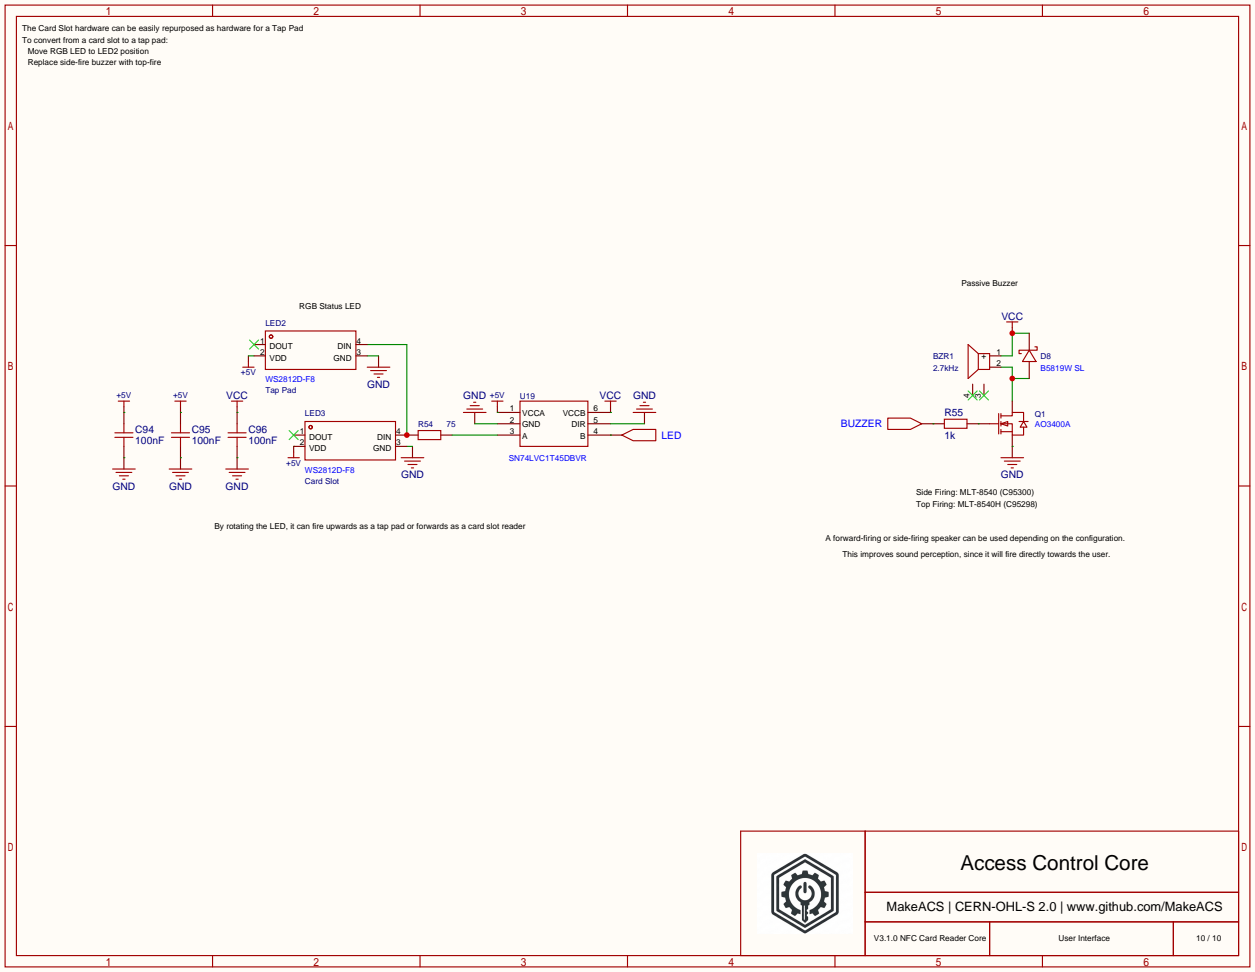
[picture p10: page 10]

The Card Slot hardware can be easily repurposed as hardware for a Tap Pad
To convert from a card slot to a tap pad:
Move RGB LED to LED2 position
Replace side-fire buzzer with top-fire

By rotating the LED, it can fire upwards as a tap pad or forwards as a card slot reader

A forward-firing or side-firing speaker can be used depending on the configuration.
This improves sound perception, since it will fire directly towards the user.
