MakeACS/HW-NFC-Core/Firmware/src/MainController.cpp

/*

----- COREDUINO -----

Coreduino is an Arduino-based firmware for the MakeACS accessEnabled Control Core. 

It is meant to run in the PIOArduino framework, allowing building for all variants of the Core.

Licensed CERN-OHL-S 2.0 (https://ohwr.org/cern/ohl-s-2.0)

More info: https://github.com/MakeACS/HW-NFC-Core

*/

#include "version.h" //Includes the version information, pulls from Github tag on release.

#include <Arduino.h>
#include "Globals.h"
#include "AudioVisualController.h"
#include "DisplayController.h"
#include "FrontendController.h"
#include "AccessManager.h"
#include "AccessLegacyBridge.h"
#include "SystemSupervisor.h"
#include "CardReader.h"
#include "BusDriver.h"
#include "TaggedSerial.h"
#include "OfflineList.h"
#include "config.h"
#include "helperFunctions.h"
#include "OfflineList.h"

namespace {
TaggedSerial<decltype(::Serial)> mainSerial(::Serial, "[main] ");
}

#define Serial mainSerial

//Libraries:
  //TODO: Go through and put all of these into the proper library system for PIOArduino.
  #include <OneWire.h>              //Replacing for WSACS API update...
  #include <ArduinoJson.h>          //Version 7.3.0 | Source: https://github.com/bblanchon/ArduinoJson
  #include <ArduinoJson.hpp>        //Version 7.3.0 | Source: https://github.com/bblanchon/ArduinoJson
  #include <WiFiClientSecure.h>     //Version 3.1.1 | Inherent to ESP32 Arduino
  #include <HTTPClient.h>           //Version 3.1.1 | Inherent to ESP32 Arduino
  #include <Preferences.h>          //Version 3.1.1 | Inherent to ESP32 Arduino
  #include <esp_wifi.h>             //Version 3.1.1 | Inherent to ESP32 Arduino
  #include <FS.h>                   //Version 3.1.1 | Inherent to ESP32 Arduino
  #include <SPIFFS.h>               //Version 3.1.1 | Inherent to ESP32 Arduino
  #include <Update.h>               //Version 3.1.1 | Inherent to ESP32 Arduino
  #include <WiFi.h>                 //Version 3.1.1 | Inherent to ESP32 Arduino
  #include "esp_timer.h"            //Version 3.1.1 | Inherent to ESP32 Arduino
#if CONFIG_IDF_TARGET_ESP32S3
  #include "esp32s3/rom/rtc.h"      //Version 3.1.1 | Inherent to ESP32 Arduino
#endif
  #include <nvs_flash.h>            //Version 3.1.1 | Inherent to ESP32 Arduino
  #include <ESP32Time.h>            //Version 2.0.6 | Source: https://github.com/fbiego/ESP32Time
  #include <WebSocketsClient.h>     //Version 2.6.1 | Source: https://github.com/Links2004/arduinoWebSockets
  #include <ESP32Ping.h>            //Version 1.6   | Source: https://github.com/marian-craciunescu/ESP32Ping
  #include <ping.h>                 //Version 1.6   | Source: https://github.com/marian-craciunescu/ESP32Ping
  #include "esp_ota_ops.h"          //Version 3.1.1 | Inherent to ESP32 Arduino
  #include <MQTTPubSubClient.h> 
  #include <SPI.h>
#if CORE_HAS_LOCAL_AUDIO_VISUAL
  #include <Adafruit_NeoPixel.h>
#endif
  #include "USB.h"
  #include <esp_system.h>
  #include <esp_mac.h>
  #include "esp_efuse.h"
  #include "esp_efuse_table.h"
#if CORE_HAS_ACCELEROMETER
  #include "SparkFun_LIS2DH12.h" //Click here to get the library: http://librarymanager/All#SparkFun_LIS2DH12
#endif
  #include <Wire.h>
  #include <mbedtls/md.h>          //Inherent to ESP32
  #include <stdio.h>
  #include <esp_crc.h>  // ESP32 built-in CRC header
  #include "esp_core_dump.h"


  #include "Device.h" //Struct definition in a header so it can be used in multiple places and in function calls

//Objects:
ESPConfig config;
  Preferences settings;
  JsonDocument ConfigJson;
  ESP32OTAPull ota;
  ESP32Time rtc;
  WebSocketsClient socket;
  MQTTPubSub::PubSubClient<1536> mqtt;
  OneWire ds(PIN_ONE_WIRE); 
#if CORE_HAS_LOCAL_AUDIO_VISUAL
  Adafruit_NeoPixel CBI(1, PIN_LED, NEO_RGB + NEO_KHZ800);
#endif
#if CORE_HAS_ACCELEROMETER
  SPARKFUN_LIS2DH12 accel;
#endif

NetworkClientSecure networkclient;
#if !CORE_HAS_LOCAL_AUDIO_VISUAL
HardwareSerial frontend(1);

//Several tasks write to the frontend UART, so each line is sent as one write under a mutex.
void frontendSend(const String &line) {
  static SemaphoreHandle_t lock = xSemaphoreCreateMutex();
  String out = line + "\r\n";
  xSemaphoreTake(lock, portMAX_DELAY);
  frontend.write((const uint8_t *)out.c_str(), out.length());
  xSemaphoreGive(lock);
}
bool frontendButtonPressed = false;
bool frontendCardDetect1 = false;
bool frontendCardDetect2 = false;
#endif

String rootCertificate; //Stores the root certificate loaded from SPIFFS

//Variables - Inter-Task Communication
bool gamerMode = 1;  //Set to 0 to disable gamer mode, i.e. cycle RGB. Used during boot.
SystemState systemState;
bool accessEnabled = 0; //Used to tell the frontend to enable the access signal to the bus. 
bool faultBeepRequested = 0; //We use the 3 beep normally for fault to indicate cannot welcome/auth due to no network, to differentiate from welcome/auth denied.

int MakerspaceNumber = 36;  // number from the makerspace's URL. We need to hard-code this for now.

//Network Disconnect Reason Tracking
volatile uint8_t lastDisconnectReason = 0;
String lastDisconnectReasonVerbose = "Initial Connection";
unsigned long long lastReconnectTime = 0;

//Variables - System channels.states
bool identifyRequested = 0; //Set to 1 to play an identification alarm/buzzer.
String defaultInputMode = "INSERT"; //Stores how we should ingest cards, when not in welcome mode.
NetworkState networkState;

//Variables - Config
String serialNumber;
NetworkConfiguration networkConfiguration;
int makerspaceId;

MqttState mqttState;


Device sensorList[10];

//Variables - Inter-Task Communication
bool configOneWire = 0; //Flag to see if we should apply a config to the attached onewire device
bool sealBroken = 0;  //Set to 1 if there is an incorrect OneWire device on the bus. 
bool reSealBus = 0;
bool overTemp = 0;    //Set to 1 if there is a device overtemperature on the bus, so we can fault. 
byte liveAddresses[5][8];      //OneWire addresses of what is currently connected, for server reporting.
int liveAddressCount = 0;                //Number of currently connected devices on the bus, for server reporting.
byte deviceCount = 0; //Tracks the number of OneWire devices found on the bus.

//Variables - Inter-Task Communication (Inside Frontend)
byte redLed = 0; //Tracks the red channel light intensity
byte greenLed = 0; //Tracks the green channel light intensity
byte blueLed = 0; //Tracks the blue channel light intensity
unsigned int buzzerTone = 0; //Set to the tone that the buzzer should play.
bool resetLed = 0; //Set to 1 to take priority over the LED controller, to indicate the restart is imminent.
bool unlockedBeep = 0;
bool singleBeep = 0;

unsigned long long nextConfigUpdate = 0; //Tracks how often we should be updating the config frontend.

ChannelSettings channelSettings;
String systemNotice = "";

//Interrupt Response Mode:
//The device can respond to an interrupt in a few different ways;
//1: "FAULT" - Immediately put the device into a fault state.
  //This is the normal operation of the interrupt pin
//2: "LOCK_TEMP" - Immediately set all channels to locked, but return to IDLE once we are no longer interrupted.
//3: "IDLE" - Put any unlocked channels into an idle state.
  //This lets the interrupt pin be used more like a "log out" button.
//4: "MESSAGE" - Simply notify the server a fauly occurred, but don't do anything.
  //Useful for situtations where interrupt is used to convey info, but not necessarily shut down access.
String interruptResponse = "FAULT";

//Variables related to any connected screen;
bool updateScreen = false;
String hmiMachineNames[4] = {"","","",""};
String hmiMakerspace;
String hmiDeviceName;
String hmiRole;
String stationName;

KeepAlivePing keepAlivePing;

bool RTSjustStarted = true; //Tracks if we just started, to send reset reason on boot.

//Creates a task and reports loudly if the heap could not provide it, so a missing task is never silent.
static void startTask(TaskFunction_t fn, const char *name, uint32_t stackBytes, void *arg) {
  if (xTaskCreate(fn, name, stackBytes, arg, 5, NULL) != pdPASS) {
    Serial.printf("[boot] FAILED to start task %s (%u byte stack), free heap %u, largest block %u\n", name, (unsigned)stackBytes, (unsigned)ESP.getFreeHeap(), (unsigned)ESP.getMaxAllocHeap());
  }
}

void setup() {
  MEM_CHECKPOINT("setup entry");
  // put your setup code here, to run once:

  //In case we crashed, immediately turn off buzzer and set LED red;
#if CORE_HAS_LOCAL_AUDIO_VISUAL
  pinMode(PIN_BUZZER, OUTPUT);
  noTone(PIN_BUZZER);
  CBI.begin();
  CBI.setBrightness(30);
  CBI.setPixelColor(0, 255, 0, 0);
  CBI.show();

  pinMode(PIN_BUTTON, INPUT); 
#endif

  busDriverInit(); //Bus pins (access, GPIO, interrupt) are owned by the BusDriver

#if USE_INTERNAL_USB_CDC
  //Set all USB-related settings, including VID/PID, product name, etc.
  USB.productName("Access Control Core");
  USB.manufacturerName("MakeACS");
  //Anything using internal CDC will use the proper internal serial number;

  uint8_t unique_id[16]; 
  
  // ESP_EFUSE_OPTIONAL_UNIQUE_ID is the constant defined in the IDF table
  esp_err_t usberr = esp_efuse_read_field_blob(ESP_EFUSE_OPTIONAL_UNIQUE_ID, unique_id, 128);

  if (usberr == ESP_OK) {
    for (int i = 0; i < 16; i++) {
      if (unique_id[i] < 0x10) serialNumber += "0"; // Lead with zero if byte < 16
      serialNumber += String(unique_id[i], HEX);
    }
    serialNumber.toUpperCase();
  }
  USB.serialNumber(serialNumber.c_str());
  USB.PID(0x82D0); //PID for Access Control Core
  USB.begin();
#endif
  Serial.begin(115200);
#if CORE_HAS_SCREEN
  Serial0.begin(115200, SERIAL_8N1, 44, 43);
#endif
#if !CORE_HAS_LOCAL_AUDIO_VISUAL
  frontend.begin(115200, SERIAL_8N1, PIN_FRONTEND_RX, PIN_FRONTEND_TX);
  frontendSend("B 0"); //Set buzzer to 0
  frontendSend("L 0,0,255"); //Set LED to blue
#endif

  Serial.println(F("STARTUP"));
  Serial.flush();
  delay(500);

  MEM_CHECKPOINT("boot, before tasks");
#if MEMORY_DIAG
  xTaskCreate(runMemoryDiagLoop, "memdiag", 3072, NULL, 1, NULL);
#endif
  sendStartupstatusMessage("Starting Tasks...");

  startTask(runAudioVisualController, "runAudioVisualController", 2048, NULL);
  startTask(watchRestartButton, "watchRestartButton", 4096, NULL); //Also runs the whole reset sequence (NVS + SPIFFS writes), which needs the stack
  startTask(runFrontendController, "Frontend", 2048, NULL); //Delivers the reset button state on 2.3.2, so it must run during network trouble too

  //Start i2C
#if CORE_HAS_ACCELEROMETER
  Wire.begin(PIN_SDA, PIN_SCL);
  accel.begin();
  accel.setScale(LIS2DH12_2g);
  accel.setDataRate(LIS2DH12_ODR_10Hz);
#endif

  //Start SPIFFS:
  if(!SPIFFS.begin(1)){
    Serial.println(F("SPIFFS Mount Failed!"));
    delay(1000);
    ESP.restart();
  }

  //Load the TLS cert from SPIFFS
  File file = SPIFFS.open("/cert.txt", FILE_READ);
  if(!file){
    Serial.println(F("No cert found in SPIFFS!"));
    rootCertificate = "Nothing here!";
  } else{
    rootCertificate = "";
    while(file.available()){
      rootCertificate += (char)file.read();
    }
  }
  file.close();

  //Load settings from memory
  settings.begin("settings", false);
  MEM_CHECKPOINT("after settings.begin");

  //Get our serial number;

  //Older devices use their onewire ID as a serial numer;
  if(settings.isKey("SerialNumber")){
    //Use old-style serial number
    serialNumber = settings.getString("SerialNumber");
    Serial.print(F("Loaded OneWire-based serial number: "));
    Serial.println(serialNumber);
  } else{
    //Otherwise, get our actual hardware ID number;

    // The ID is 128 bits = 16 bytes
    uint8_t unique_id[16]; 
    
    // ESP_EFUSE_OPTIONAL_UNIQUE_ID is the constant defined in the IDF table
    esp_err_t err = esp_efuse_read_field_blob(ESP_EFUSE_OPTIONAL_UNIQUE_ID, unique_id, 128);

    if (err == ESP_OK) {
      Serial.print("Serial Number: ");

      serialNumber = ""; //Overwrite anything in the string.

      for (int i = 0; i < 16; i++) {
        if (unique_id[i] < 0x10) serialNumber += "0"; // Lead with zero if byte < 16
        serialNumber += String(unique_id[i], HEX);
      }
      serialNumber.toUpperCase();
      Serial.print(serialNumber);
      Serial.println();
    } else {
      Serial.printf("Error reading eFuse: 0x%X\n", err);
      Serial.println("Note: This ID may not exist on original ESP32 (Non-S2/S3) models.");
    }
  }



  //Get our MAC address for printing, in V3.0.0 hardware this is our base MAC
  Serial.print(F("WiFi MAC Address: "));
  Serial.println(getBaseMacAddress());
#if CORE_HAS_ETHERNET
  Serial.print(F("Ethernet MAC Address: "));
  Serial.println(getEthernetMacAddress());
#endif

  migrateLegacySettings();

  if(!settings.isKey("net.server")){
    //We don't have a valid config?
    sendStartupstatusMessage("ERROR: Missing Config!");
    //Initialize the ESP Configurator:
    startESPConfig();
    while(1){
      delay(100);
    }
  }

  if(!settings.isKey("channels.count")){
    //channelSettings.count is new in 2.1.4, set to 1 if no value
    settings.putString("channels.count", "1");
  }
  channelSettings.count = settings.getString("channels.count").toInt();

  if(!settings.isKey("channels.tap0")){
    //Tap Duration is new in 2.1.4, set to 0 if no value.
    settings.putUInt("channels.tap0", 0);
    settings.putUInt("channels.tap1", 0);
    settings.putUInt("channels.tap2", 0);
    settings.putUInt("channels.tap3", 0);
  }
  for(int i = 0; i < 4; i++){
    String key = "channels.tap" + String(i);
    channelSettings.tapDurations[i] = settings.getUInt(key.c_str());
  }

  if(!settings.isKey("access.input")){
    //inputMode is new in 2.1.4, set to "INSERT" if no value.
    settings.putString("access.input", "INSERT");
  }
  defaultInputMode = settings.getString("access.input");

  if(!settings.isKey("access.intResp")){
    //Interrupt Response is new in 2.1.4, set to "FAULT" if no value.
    settings.putString("access.intResp", "FAULT");
  }
  interruptResponse = settings.getString("access.intResp");

  if(!settings.isKey("station.name")){
    //stationName is new in 2.1.4, set to "Generic ACS" if no value.
    settings.putString("station.name", "Generic MakeACS");
  }
  stationName = settings.getString("station.name");

  if(!settings.isKey("makerspace.num")){
    //MakerspaceNumber (SpaceNum) is new in 2.1.4, set to 36 (Atrium Makerspace) if no value.
    settings.putInt("makerspace.num", 36);
  }
  MakerspaceNumber = settings.getInt("makerspace.num");

  //Get the reset reason;
  if(settings.isKey("system.reset")){
    //We reset for some known reason
    systemState.resetReason = settings.getString("system.reset");
    settings.remove("system.reset"); //So we know we read it.
  } else{
    systemState.resetReason = "Unknown";
  }

  networkConfiguration.serverAddress = settings.getString("net.server");
  networkConfiguration.wifiPassword = settings.getString("net.password");
  if(networkConfiguration.wifiPassword.equalsIgnoreCase("null")){
    //Use a real NULL password.
    networkConfiguration.wifiPassword = "";
  }
  networkConfiguration.wifiSsid = settings.getString("net.ssid");
  networkConfiguration.serverAddress = settings.getString("net.server");
  networkConfiguration.mqttKey = settings.getString("net.mqttKey");
  int TimezoneHr;
  if(settings.isKey("system.timezone")){
    TimezoneHr = settings.getString("system.timezone").toInt();
  } else{
    TimezoneHr = -4; //Hardcoded EST
  }
  rtc.offset = TimezoneHr * 3600;
  makerspaceId = settings.getString("makerspace.id").toInt();

  Serial.println(F("Settings loaded."));
  MEM_CHECKPOINT("settings loaded");
  Serial.flush();

  sendStartupstatusMessage("Settings Loaded.");

  //Initialize the ESP Configurator:
  startESPConfig();

  Serial.println(F("Started Tasks."));
  Serial.flush();

  //Start the shared SPI bus here. It is used by the NFC reader and Ethernet (when present), so it is owned by the main controller.
  //Each device must only access it inside SPI.beginTransaction()/endTransaction(), which holds the bus lock.
  //SCK, MISO, MOSI, SS
  SPI.begin(PIN_SPI_SCK, PIN_SPI_MISO, PIN_SPI_MOSI, -1);

  //Start the NFC reader before anything else uses the bus, so its chip select is parked high.
  cardReaderInit();

#if CORE_HAS_ETHERNET
  const bool ethernetReady = initializeEthernet();
#else
  const bool ethernetReady = false;
#endif

  Serial.println(F("Started SPI."));
  Serial.flush();

  if (!ethernetReady) {
    sendStartupstatusMessage("Starting WiFi...");
    WiFi.mode(WIFI_STA);
    WiFi.onEvent([](WiFiEvent_t event, WiFiEventInfo_t info) {
      if (event == ARDUINO_EVENT_WIFI_STA_DISCONNECTED) {
        if(lastDisconnectReason == 0){
          //Only log the first disconnect reason, in case there are multiples.
          lastDisconnectReason = info.wifi_sta_disconnected.reason;
          lastDisconnectReasonVerbose = disconnectReasonToString(lastDisconnectReason);
          Serial.print(F("WiFi disconnected. Reason: "));
          Serial.print(lastDisconnectReasonVerbose);
          Serial.print(F(" - "));
          Serial.println(lastDisconnectReason);
        }
      }
    });
    WiFi.begin(networkConfiguration.wifiSsid, networkConfiguration.wifiPassword);
    MEM_CHECKPOINT("after WiFi.begin");
    WiFi.setSleep(false);
    WiFi.setAutoReconnect(true);
    unsigned long WiFiStart = millis64();

    if (WiFi.status() != WL_CONNECTED) {
      WiFi.reconnect();
      Serial.println(F("Waiting for first WiFi connect"));
      while (WiFi.status() != WL_CONNECTED && millis64() - WiFiStart < 15000) {
        Serial.println(".");
        delay(2000);
      }
    }
    //Wifi connected.
    lastDisconnectReason = 99;
    //We store 99 here so that if we have a network disconnect, but do not register a wifi disconnect, we do not blame it on the wifi.
  }

  bool otaVerified = false;

  if (ethernetReady || WiFi.status() == WL_CONNECTED) {
    if (ethernetReady) {
      networkState.transport = NetworkState::Transport::Ethernet;
      Serial.println(F("Ethernet connected."));
      sendStartupstatusMessage("Ethernet Started.");
    } else {
      networkState.transport = NetworkState::Transport::WiFi;
      Serial.println(F("WiFi connected."));
      sendStartupstatusMessage("WiFi Started.");
    }

#if CORE_HAS_SCREEN
    // Also get rid of "No NET" on screen
    JsonDocument NoNetStart;
    NoNetStart["noNetwork"] = false;
    String NoNetToSend;
    serializeJson(NoNetStart, NoNetToSend);
    Serial0.println(NoNetToSend);
#endif

    delay(500);

    // --- OTA LOGIC STARTS HERE ---
    // We only verify and check for updates if we are actually online.

    if(settings.getBool("ota.enable", true)){
      MEM_CHECKPOINT("before OTA check");
    sendStartupstatusMessage("Checking for OTA...");
      Serial.println(F("Checking for OTA..."));

      // 1. Configure all OTA settings first
      ota.EnableSerialDebug();
      //We use the same cert on our server as Github does.
      ota.SetCACert(rootCertificate.c_str());
      ota.SetCallback(handleOtaProgress);
      String targetFilename = "firmware_" + String(PIOENV_NAME) + ".bin";
      Serial.print(F("OTA Target Filename: "));
      Serial.println(targetFilename);
      ota.SetTargetFilename(targetFilename.c_str());

      // 2. Verify the current firmware can reach the JSON (or rollback)
      String jsonUrl = settings.getString("ota.url", "https://raw.githubusercontent.com/MakeACS/HW-NFC-Core/main/Firmware/OTADirectory.json");
      otaVerified = ota.VerifyOrRevert(jsonUrl.c_str(), FIRMWARE_VERSION);
      MEM_CHECKPOINT("after OTA verify");

      // 3. Check for a new update before we continue;
      int otaresp = ota.CheckForOTAUpdate(jsonUrl.c_str(), FIRMWARE_VERSION);
      MEM_CHECKPOINT("before OTA update check");
      Serial.print(F("OTA Response: "));
      Serial.println(getOtaErrorText(otaresp));

      #ifndef REDUCED_CONFIG
      config.updateInformation("Firmware", "last-ota", getOtaErrorText(otaresp));
      #endif

      if(otaresp == ESP32OTAPull::SKIPPED_BAD_VERSION){
        //Important one; this is a failed OTA that was reverted. We should report it.
        String revertMessage = "OTA Reverted! Version: ";
        //Close the standard preferences.
        settings.end();
        delay(10);
        settings.begin("ota_prefs", true);
        String badVer = settings.getString("bad_ver", "");
        settings.end();
        //Re-open the main settings folder;
        settings.begin("settings", false);
        revertMessage += badVer;
        revertMessage += " failed boot tests. Reverted to ";
        revertMessage += FIRMWARE_VERSION;
        mqttState.messageToSend = true;
        mqttState.statusMessage = revertMessage;
        Serial.println(revertMessage);
        #ifndef REDUCED_CONFIG
        config.updateInformation("Firmware", "last-ota", revertMessage);
        #endif
      }
    } else{
      Serial.println(F("OTA skipped because it is disabled."));
      #ifndef REDUCED_CONFIG
      config.updateInformation("Firmware", "last-ota", "[bad]OTA is disabled!");
      #endif
    }


    // --- OTA LOGIC ENDS HERE ---

  } else {
    // Device is offline. We skip OTA checks entirely to avoid false rollbacks.
    Serial.println(F("No network interface connected. Booting offline."));
    sendStartupstatusMessage("Network failed to start?");
  }

  // If we made it past the OTA (or skipped it because offline),
  // then we are ready for normal operation.

  //Before we continue, let's figure out why we restarted.
  Serial.println(F("Checking reset reason..."));
  if(otaVerified){
    //We should report to the server that we updated.
    mqttState.messageToSend = true;
    mqttState.statusMessage = "OTA Update Successful: " + String(PIOENV_NAME) + " v" + FIRMWARE_VERSION;
    systemState.resetReason = "OTA Update Successful: " + String(PIOENV_NAME) + " v" + FIRMWARE_VERSION;
    Serial.println(F("Reset Reason: OTA Update Successful."));
  } else{
    //We restart for something other than an OTA
    JsonDocument ResetDoc;
    esp_reset_reason_t reason = esp_reset_reason();
    if(reason == ESP_RST_INT_WDT || reason == ESP_RST_TASK_WDT || reason == ESP_RST_WDT){
      //Watchdog reset
      mqttState.logToSend = true;
      mqttState.logType = "reset-log";
      ResetDoc["reset-reason"] = reason;
      ResetDoc["report"] = "Watchdog Reset. Source Unknown?";
      Serial.println(F("Reset Reason: Watchdog Reset. Source Unknown?"));
      systemState.resetReason = "Watchdog Reset, Source Unknown?";
    }
    else if(reason == ESP_RST_BROWNOUT || reason == ESP_RST_PWR_GLITCH){
      //Power-related reset
      mqttState.logToSend = true;
      mqttState.logType = "reset-log";
      ResetDoc["reset-reason"] = reason;
      ResetDoc["report"] = "Power Issue Reset.";
      mqttState.messageToSend = true;
      mqttState.statusMessage = "Device restarted due to power anomaly. Check wiring and ensure properly-sized power supply is used.";
      Serial.println(F("Reset Reason: Power Issue Reset."));
      systemState.resetReason = "Power-Related Reset. Possible brownout?";
    }
    else if(reason == ESP_RST_CPU_LOCKUP || reason == ESP_RST_PANIC){
      //CPU lockup or panic reset
      mqttState.logToSend = true;
      mqttState.logType = "reset-log";
      ResetDoc["reset-reason"] = reason;
      ResetDoc["version"] = FIRMWARE_VERSION;
      ResetDoc["hardware"] = PIOENV_NAME;
      Serial.println(F("Reset Reason: CPU Lockup or Panic Reset. Attempting to get core dump summary..."));
      // Get the core dump summary
      esp_core_dump_summary_t summary;
      esp_err_t crasherr = esp_core_dump_get_summary(&summary);
      if (crasherr != ESP_OK) {
        Serial.println(F("Failed to get core dump summary?"));
        ResetDoc["report"] = "CPU Lockup or Panic Reset, with no core dump summary available.";
        systemState.resetReason = "CPU Lockup or Panic Reset, with no core dump summary available.";
        Serial.println(F("Failed to get core dump summary?"));
      } else{
        ResetDoc["report"] = "CPU Lockup or Panic Reset, core dump summary attached.";
        systemState.resetReason = "CPU Lockup or Panic Reset, core dump summary extracted.";
        Serial.println(F("Core dump summary retrieved successfully. Sending to server..."));
        JsonObject dumpDoc = ResetDoc["core-dump-summary"].to<JsonObject>();
        //Task ID
        dumpDoc["task"] = summary.exc_task;
        //Firmware SHA (Convert the 32-byte array to a 64-character hex string)
        char sha_str[65] = {0};
        for (int i = 0; i < 32; i++) {
            sprintf(&sha_str[i * 2], "%02x", summary.app_elf_sha256[i]);
        }
        dumpDoc["firmware_sha"] = sha_str;

        //Exception Registers (Formatted as Hex strings so they are easy to read)
        char hex_buf[20];
        sprintf(hex_buf, "0x%08lx", (unsigned long)summary.exc_pc);
        dumpDoc["pc"] = hex_buf;
        sprintf(hex_buf, "0x%04lx", (unsigned long)summary.ex_info.exc_cause);
        dumpDoc["exc_cause"] = hex_buf;
        sprintf(hex_buf, "0x%08lx", (unsigned long)summary.ex_info.exc_vaddr);
        dumpDoc["exc_vaddr"] = hex_buf;

        //backtrace info
        JsonObject btDoc = dumpDoc["backtrace"].to<JsonObject>();
        esp_core_dump_bt_info_t bt_info = summary.exc_bt_info;
        btDoc["depth"] = bt_info.depth;
        btDoc["corrupted"] = bt_info.corrupted;
        JsonArray frames = btDoc["frames"].to<JsonArray>();
        for (uint32_t i = 0; i < bt_info.depth; i++) {
            char bt_hex[20];
            sprintf(bt_hex, "0x%08lx", (unsigned long)bt_info.bt[i]);
            frames.add(bt_hex);
        }
        //After reading the core dump summary, we should clear it so we don't keep sending it.
        esp_core_dump_image_erase();
      }
    }
    else{
      //All other reset reasons are considered nominal.
      Serial.println(F("Nominal reset reason, no need to send a report."));
    }
    if(mqttState.logToSend){
      //We found a notable reset reason to send, let's package it to send out.
      String resetPayload;
      serializeJson(ResetDoc, resetPayload);
      mqttState.logMessage = resetPayload;
    }
  }
  #ifndef REDUCED_CONFIG
  //Update the reset reason on the config frontend
  config.updateInformation("Uptime", "reason", systemState.resetReason);
  #endif

  MEM_CHECKPOINT("before MQTT connect");
  sendStartupstatusMessage("Connecting MQTT...");

  mqtt.begin(socket); //Enable MQTT on the websocket

  connectNetwork();
  
  //If we cared about why we restarted, this'd be the place to handle it.

  //We should initialize the OneWire bus here, check for the right devices, etc.
  //TODO will enable onewire in future version, needs more testing to be reliable. 

  //Get the offline list from SPIFFS
  loadListFromSPIFFS();
  Serial.println(F("Loaded offline list from memory."));
  #ifndef REDUCED_CONFIG
  config.updateInformation("Total", "offline-count", String(getOfflineListSize()));
  #endif

  //Time to loop!
  static AccessConfig accessConfig;
  accessConfig.inputMode = inputModeFromApiString(defaultInputMode.c_str());
  accessConfig.interruptResponse = interruptResponseFromApiString(interruptResponse.c_str());
  accessConfig.channelCount = channelSettings.count;
  for(int i = 0; i < CORE_MAX_CHANNELS; i++){
    accessConfig.tapDurationMs[i] = channelSettings.tapDurations[i] * 1000;
  }
  accessManagerInit(accessConfig);
  startTask(runAccessManagerLoop, "runAccessManagerLoop", 4096, &accessConfig);
  #ifdef REDUCED_CONFIG
  startTask(runAccessBridgeLoop, "runAccessBridgeLoop", 2048, NULL); //No config frontend on this build
#else
  startTask(runAccessBridgeLoop, "runAccessBridgeLoop", 4096, NULL);
#endif
  startTask(runCardReaderLoop, "runCardReaderLoop", 4096, NULL);
  startTask(runBusDriverLoop, "runBusDriverLoop", 3072, NULL);
  startTask(runSystemSupervisorLoop, "runSystemSupervisorLoop", 2560, NULL);
  gamerMode = 0; //Disable the startup lighting

#if CORE_HAS_SCREEN
  startTask(runScreenController, "ScreenController", 4096, NULL);
#endif

}

void loop() {
  // put your main code here, to run repeatedly:

  delay(10);

  //Step 0: Call the MQTT updater;
  mqtt.update();

  delay(10);

  #ifndef REDUCED_CONFIG
  //Every 5 seconds, update the config:
  if(millis64() >= nextConfigUpdate){
    nextConfigUpdate = millis64() + 5000;
    updateConfig();
  }
  #endif

  //Send the reset reason on boot once we have nothing else pending;
  if(RTSjustStarted && !mqttState.logToSend){
    RTSjustStarted = false;
    mqttState.logMessage = "reset-reason: " + systemState.resetReason;
    mqttState.logToSend = true;
  }

  //Report interrupt edges to the history when the response mode is MESSAGE
  {
    static bool lastInterrupted = false;
    bool nowInterrupted = bus.interrupted;
    if(nowInterrupted != lastInterrupted && interruptResponse == "MESSAGE" && !mqttState.messageToSend){
      lastInterrupted = nowInterrupted;
      mqttState.statusMessage = nowInterrupted ? "Interrupt Triggered!" : "Interrupt Cleared";
      mqttState.messageToSend = true;
    } else if(nowInterrupted != lastInterrupted && interruptResponse != "MESSAGE"){
      lastInterrupted = nowInterrupted;
    }
  }

  //Ping-related checks;
  if(keepAlivePing.nextTime <= millis64()){
    //It is time to send a ping 
    if(keepAlivePing.missedPing && keepAlivePing.pingPending){
      //We missed 2 pings in a row, something may be wrong with the network?
      if(!networkState.unavailable){
        networkState.unavailable = true;
        connectNetwork(); //Try to re-connect to the network.
      }
    } else{
       keepAlivePing.nextTime = millis64() + keepAlivePing.gapTime;
      String PingTopic = mqttState.baseTopic + "/ping";
      publishMqttstatusMessage(PingTopic, "Ping!");
      keepAlivePing.lastPingTime = millis64();
      //Did we recently send a ping and not hear back yet?
      if(keepAlivePing.pingPending){
        //We didn't hear back from the last ping, so we missed it.
        keepAlivePing.missedPing = true;
      } else{
        //We didn't send a ping previously, so we are now waiting for a ping response.
        keepAlivePing.pingPending = true;
      }
    }
  }

  //Step 4: Communicate with the server

  //Outbound messages are built from the AccessManager's published snapshot.
  static AccessSnapshot snap;
  static ChannelState reportedStates[CORE_MAX_CHANNELS]; //Last state the server was told about
  static AccessMode lastSnapMode = AccessMode::Normal;
  accessGetSnapshot(snap);
  const bool welcomeMode = snap.mode == AccessMode::Welcome;
  if(lastSnapMode == AccessMode::Welcome && !welcomeMode){
    //State changes were not reported while welcoming, so report from scratch.
    for(int i = 0; i < CORE_MAX_CHANNELS; i++) reportedStates[i] = ChannelState::Unknown;
  }
  lastSnapMode = snap.mode;
  bool anyStateUnknown = false;
  for(int i = 0; i < snap.channels.count; i++){
    if(snap.channels.ch[i].state == ChannelState::Unknown) anyStateUnknown = true;
  }
  //Only send messages if we have a connection:
  if(mqtt.isConnected() && !networkState.unavailable){

    JsonDocument outgoing; //Json to construct the outgoing message in

     //Send any outgoing messages
     //But only we if have network

    if(mqttState.messageToSend){
      //Send a message to the history
      mqttState.messageToSend = false;
      outgoing["auditLog"] = true; //Print in the history
      outgoing["message"] = mqttState.statusMessage;
      outgoing["category"] = "message";
      String MessagePayload;
      serializeJson(outgoing, MessagePayload);
      outgoing.clear(); //Clear so other sends can use it
      String MessageTopic = mqttState.baseTopic + "/log";
      publishMqttstatusMessage(MessageTopic, MessagePayload);
    }
    if(mqttState.logToSend){
      //Send a log to the audit logs (not the user-visible history)
      mqttState.logToSend = false;
      outgoing["auditLog"] = false; //Don't print in the history
      outgoing["message"] = mqttState.logMessage;
      outgoing["category"] = mqttState.logType;
      String LogPayload;
      serializeJson(outgoing, LogPayload);
      outgoing.clear();
      String LogTopic = mqttState.baseTopic + "/log";
      publishMqttstatusMessage(LogTopic, LogPayload);
      mqttState.logType = "message"; //Default value unless we say otherwise.
    }
    if(mqttState.sendAuth){
      //Send an auth request to the server
      mqttState.sendAuth = false;
      outgoing["state"] = "UNLOCKED";
      outgoing["cardTagID"] = card.UID;
      String AuthPayload;
      serializeJson(outgoing, AuthPayload);
      outgoing.clear();
      String AuthTopic = mqttState.baseTopic + "/authTo/request";
      publishMqttstatusMessage(AuthTopic, AuthPayload);

    }
    if(mqttState.stateChange){
      //Send report of a changed state
      mqttState.stateChange = false;
      if(!welcomeMode){
        //We don't report state change when we are in welcoming.
        JsonArray stateChannels = outgoing["channels"].to<JsonArray>();
        for( int i = 0; i < snap.channels.count; i++){
          const Channel &c = snap.channels.ch[i];
          if(c.state != reportedStates[i]){
            JsonObject stateObject = stateChannels.createNestedObject();
            stateObject["channelID"] = i;
            stateObject["fromState"] = toApiString(reportedStates[i]);
            stateObject["toState"] = toApiString(c.state);
            //The server doesn't recognize the "LOCK_TEMP" state change reason
            //So we replace if with "LOCAL":
            stateObject["reason"] = (c.changeReason == ChangeReason::LockTemp) ? "LOCAL" : toApiString(c.changeReason);
            //Update the preserved last state;
            reportedStates[i] = c.state;
          }
        }
        outgoing["currentCardTag"] = card.UID;
        String StateChangePayload;
        serializeJson(outgoing, StateChangePayload);
        outgoing.clear();
        String StateChangeTopic = mqttState.baseTopic + "/stateChange";
        publishMqttstatusMessage(StateChangeTopic, StateChangePayload);
        //At the end, set change reason to nothing:
      }
    }
    if(mqttState.reportConfig){
      //Report the current configuration
      mqttState.reportConfig = false;
      JsonArray configChannels = outgoing["channels"].to<JsonArray>();
      for(int i = 0; i < channelSettings.count; i++){
        JsonObject configObject = configChannels.createNestedObject();
        configObject["channelID"] = i;
        configObject["tempDuration"] = channelSettings.tapDurations[i];
      }
      //Temp disable network inteface reporting, as it is not yet implemented on the server side.
      //outgoing["networkInterface"] = getActiveNetworkInterface();
      outgoing["inputMode"] = toApiString(snap.inputMode);
      JsonObject configDeployment = outgoing["deployment"].to<JsonObject>();
      configDeployment["SN"] = serialNumber;
      JsonArray configComponents = configDeployment["components"].to<JsonArray>();
      //Iterate through and add every component on the bus to the components array;
      for(int i = 0; i < liveAddressCount; i++){
        JsonObject deviceObj = configComponents.createNestedObject();
        // Convert the 8-byte address to a Hex String for JSON
        char addrStr[17]; 
        snprintf(addrStr, sizeof(addrStr), "%02X%02X%02X%02X%02X%02X%02X%02X",
        liveAddresses[i][0], liveAddresses[i][1], liveAddresses[i][2], liveAddresses[i][3],
        liveAddresses[i][4], liveAddresses[i][5], liveAddresses[i][6], liveAddresses[i][7]);
        deviceObj["SN"] = String(addrStr);
        for(int j = 0; j < deviceCount; j++) {
          if(memcmp(liveAddresses[i], sensorList[j].address, 8) == 0) {
            // Here we grab the deviceMode and other data from the struct
            deviceObj["type"] = sensorList[j].deviceMode; 
            deviceObj["identifier"] = sensorList[j].deviceID; //serverAddress doesn't expect this yet, but we should send it
            break;
          }
        }
      }
      JsonObject flags = outgoing["flags"].to<JsonObject>();
      flags["lockWhenIdle"] = snap.lockWhenIdle;
      flags["restartWhenUnused"] = snap.restartWhenUnused;
      flags["welcoming"] = welcomeMode;
      String FWVer = "CoreDuino " + String(FIRMWARE_VERSION);
      outgoing["firmware"] = FWVer;
      //TODO verify this is the right key
      /*
      #ifdef NICE_HARDWARE_NAME
      outgoing["hardware"] = NICE_HARDWARE_NAME;
      #else
      outgoing["hardware"] = HARDWARE_VERSION;
      #endif
      */
      String ConfigPayload;
      serializeJson(outgoing, ConfigPayload);
      outgoing.clear();
      String ConfigTopic = mqttState.baseTopic + "/config/report";
      publishMqttstatusMessage(ConfigTopic, ConfigPayload);
    }
    if(mqttState.requestInfo){
      //Request information from the server
      mqttState.requestInfo = false;
      JsonArray infoFields = outgoing["fields"].to<JsonArray>();
      if(rtc.getYear() <= 2024){
        //The RTC is not set, let's request the time.
        infoFields.add("TIME");
      }
      //Check if any of the states or HobbsTimers are unknown;
      bool AskForStates = false;
      bool AskForHobbs = false;
      AskForStates = anyStateUnknown;
      for(int i = 0; i < snap.channels.count; i++){
        if(snap.channels.ch[i].hobbsNow(millis64()) == 0){
          AskForHobbs = true;
        }
      }
      if(AskForStates){
        //We don't know what state we should be in, so request it. 
        infoFields.add("STATE");
      }
      if(AskForHobbs){
        //We do not know what the Hobbs timer should be at, let's request that.
        infoFields.add("HOBBS_TIME");
      }
      infoFields.add("FLAGS"); //Check our flags, mostly for welcoming
      infoFields.add("HMI"); //Request human-readable info for any attached interface.
      String InfoPayload;
      serializeJson(outgoing, InfoPayload);
      outgoing.clear();
      String InfoTopic = mqttState.baseTopic + "/info/request";
      publishMqttstatusMessage(InfoTopic, InfoPayload);
    }
    if(mqttState.sendStatus && !anyStateUnknown){
      //Send our current status to the server, we do not send it if we do not know our state. 
      mqttState.sendStatus = false;
      JsonArray statusChannels = outgoing["channels"].to<JsonArray>();
      if(!welcomeMode){
        //We don't send this in welcoming mode
        for(int i = 0; i < snap.channels.count; i++){
          JsonObject statusObject = statusChannels.createNestedObject();
          statusObject["channelID"] = i;
          statusObject["state"] = toApiString(snap.channels.ch[i].state);
          statusObject["hobbsTime"] = snap.channels.ch[i].hobbsNow(millis64());
        }
      }
      outgoing["currentCardTag"] = card.UID;
      String StatusPayload;
      serializeJson(outgoing, StatusPayload);
      outgoing.clear();
      String StatusTopic = mqttState.baseTopic + "/status";
      publishMqttstatusMessage(StatusTopic, StatusPayload);
    }
    if(mqttState.sendWelcome){
      //Send a welcome message to the server
      mqttState.sendWelcome = false;
      outgoing["cardTagID"] = card.UID;
      String WelcomePayload;
      serializeJson(outgoing, WelcomePayload);
      outgoing.clear();
      String WelcomeTopic = mqttState.baseTopic + "/welcome/request";
      publishMqttstatusMessage(WelcomeTopic, WelcomePayload);
    }

  }

    JsonDocument incoming; //Json doucment to parse the incoming

    //Access-related API responses are handed to the AccessManager, which parses and acts on them.
    //If its inbox is full the flag stays set and we try again next pass.
    if(mqttState.newAuth && accessPostPayload(AccessEventType::ApiAuthResult, mqttState.authResponse.c_str())){
      mqttState.newAuth = false;
      updateScreen = true;
    }
    if(mqttState.newInfo && accessPostPayload(AccessEventType::ApiInfo, mqttState.infoResponse.c_str())){
      //State, hobbs and flags go to the AccessManager. We keep the parts that are not access related.
      Serial.println(F("[main] Info response handed to the AccessManager."));
      mqttState.newInfo = false;
      deserializeJson(incoming, mqttState.infoResponse);
      //Process the HMI info:
      if(incoming.containsKey("hmi")){
        hmiRole = incoming["hmi"]["role"].as<String>();
        hmiDeviceName = incoming["hmi"]["deviceName"].as<String>();
        hmiMakerspace = incoming["hmi"]["makerspace"].as<String>();
        JsonArray channelsArray = incoming["hmi"]["channels"];
        for (JsonObject channel : channelsArray){
          int channelID = channel["channelID"];
          if(channelID >= 0 && channelID < CORE_MAX_CHANNELS){
            hmiMachineNames[channelID] = channel["pairedEntity"].as<String>();
          }
        }
        #ifndef REDUCED_CONFIG
        //Update the frontend with the new info;
        config.updateInformation("Device", "makerspace", hmiMakerspace);
        config.updateInformation("Device", "name", hmiDeviceName);
        for(int i = 0; i < channelSettings.count; i++){
          String source = "Channel " + String(i);
          config.updateInformation(source, "channel-equipment", hmiMachineNames[i]);
        }
        #endif
      }
      //Set the time;
      if(incoming.containsKey("time")){
        unsigned long long millisecondTime = incoming["time"];
        rtc.setTime(millisecondTime/1000);
        Serial.print(F("Time set to: "));
        Serial.println(rtc.getDateTime(true));
        //Once we know the time, we should clean up our offline user list;
        cleanupOfflineList(rtc.getEpoch());
      }
      mqttState.reportConfig = true; //Once we get some info, we should send our configuration.
      mqttState.sendStatus = true; //Once we get some info, we should send our status.
      updateScreen = true;
    }
    if(mqttState.newCommand && accessPostPayload(AccessEventType::ApiCommand, mqttState.commandResponse.c_str())){
      //State changes, flags and hobbs go to the AccessManager. Actions stay here.
      mqttState.newCommand = false;
      deserializeJson(incoming, mqttState.commandResponse);
      //Action to do something
      if(incoming.containsKey("action")){
        if(incoming["action"] == "RESTART"){
          Serial.println(F("serverAddress commanded restart!"));
          Serial.flush();
          systemState.resetReason = "Server Ordered";
          systemState.requestReset = true;
        }
        if((incoming["action"] == "SEAL") && sealBroken){
          Serial.println(F("Server commanded bus integrity re-seal."));
          reSealBus = true;
        }
        if(incoming["action"] == "IDENTIFY"){
          Serial.println(F("Server commanded identify."));
          identifyRequested = !identifyRequested;
          if(!identifyRequested){
            //Play a single beep to end the identify command.
            singleBeep = true;
          }
        }
        if(incoming["action"] == "SCHEDULED_RESTART"){
          Serial.println(F("serverAddress indicated it is time for a scheduled restart."));
          systemState.scheduledRestart = true;
        }

      }
      updateScreen = true;
    }
    if(mqttState.newWelcome && accessPostPayload(AccessEventType::ApiWelcomeResult, mqttState.welcomeResponse.c_str())){
      mqttState.newWelcome = false;
      updateScreen = true;
    }
    
}
