MakeACS/HW-NFC-Core/Firmware/src/FrontendController.cpp

/*

FrontendController

Used to handle the secondary MCU that is present on 2.3.2 hardware, which handles the audio and visuals, as well as card detect.

*/


#include "Globals.h"
#include "FrontendController.h"

//The V2 frontend sends newline-delimited B n and S1/S2 n records; these fields are read by fixed character offsets.
void runFrontendController(void *pvParameters) {
#if !CORE_HAS_LOCAL_AUDIO_VISUAL
  unsigned long long nextPollTime = 0;
  while (true) {
    if (nextPollTime <= millis64()) {
      nextPollTime = millis64() + 1000;
      frontendSend("P");
    }

    while (frontend.available()) {
      String message = frontend.readStringUntil('\n');
      message.trim();
      if (message.length() < 3) {
        continue;
      }

      if (message[0] == 'B') {
        frontendButtonPressed = message[2] == '1';
      } else if (message[0] == 'S') {
        const bool cardDetected = message[3] != '1';
        if (message[1] == '1') {
          frontendCardDetect1 = cardDetected;
        } else {
          frontendCardDetect2 = cardDetected;
        }
      }
    }

    vTaskDelay(pdMS_TO_TICKS(25));
  }
#else
  vTaskDelete(NULL);
#endif
}
