MakeACS/HW-NFC-Core/Firmware/src/Globals.h

#pragma once

#include <Arduino.h>

#ifndef CORE_VARIANT_HEADER
#define CORE_VARIANT_HEADER "variants/CoreV3_0_0.h"
#endif

#include CORE_VARIANT_HEADER

#include <OneWire.h>
#include <ArduinoJson.h>
#include <ArduinoJson.hpp>
#include <WiFiClientSecure.h>
#include <HTTPClient.h>
#include <Preferences.h>
#include <esp_wifi.h>
#include <FS.h>
#include <SPIFFS.h>
#include <Update.h>
#include <WiFi.h>
#if CORE_HAS_ETHERNET
#include <ETH.h>
#endif
#include "esp_timer.h"
#if CONFIG_IDF_TARGET_ESP32S3
#include "esp32s3/rom/rtc.h"
#endif
#include <nvs_flash.h>
#include <ESP32Time.h>
#include <WebSocketsClient.h>
#include <ESP32Ping.h>
#include <ping.h>
#include "esp_ota_ops.h"
#include <MQTTPubSubClient.h>
#include <SPI.h>
#if CORE_HAS_LOCAL_AUDIO_VISUAL
#include <Adafruit_NeoPixel.h>
#endif
#include "USB.h"
#include <esp_system.h>
#include <esp_mac.h>
#include "esp_efuse.h"
#include "esp_efuse_table.h"
#if CORE_HAS_ACCELEROMETER
#include "SparkFun_LIS2DH12.h"
#endif
#include <Wire.h>
#include <mbedtls/md.h>
#include <stdio.h>
#include <esp_crc.h>
#include "ESP32OTAPullSecure.h"
#include "ESPConfig.h"

#include "Device.h"

#define STATUS_INTERVAL 15000

struct NetworkState {
	bool unavailable = true;
	enum class Transport { None, WiFi, Ethernet } transport = Transport::None;
	bool tryReconnect = false;
};

struct NetworkConfiguration {
	String wifiPassword;
	String wifiSsid;
	String serverAddress;
	String mqttKey;
};

struct MqttState {
	String authResponse;
	bool newAuth = false;
	String infoResponse;
	bool newInfo = false;
	String commandResponse;
	bool newCommand = false;
	bool newPing = true;
	bool sendPing = false;
	unsigned long long nextPingTime = 0;
	String welcomeResponse;
	bool newWelcome = false;
	String baseTopic;
	String statusMessage;
	bool messageToSend = false;
	bool logToSend = false;
	String logMessage;
	String logType;
	bool sendAuth = false;
	bool stateChange = false;
	bool reportConfig = false;
	bool requestInfo = false;
	bool sendStatus = false;
	bool sendWelcome = false;
};

struct SystemState {
	bool requestReset = false;
	String resetReason;
	bool scheduledRestart = false;
	unsigned long long scheduledRestartTime = 0;
	bool imminentShutdown = false;
	unsigned long long nextStatusTime = 0;
};

//Stored channel configuration (from settings). Runtime channel state lives in the AccessManager snapshot.
struct ChannelSettings {
	static constexpr byte kMaximumChannels = 4;

	byte count = 0;
	unsigned long tapDurations[kMaximumChannels] = {0, 0, 0, 0}; //Seconds
};

struct KeepAlivePing {
	uint64_t gapTime = 2000;
	uint64_t nextTime = 0;
	uint64_t lastPingTime = 0;
	bool missedPing = false;
	bool pingPending = false;
};

String disconnectReasonToString(uint8_t reason);

void sendDisplaychannelState(bool sendRarely = false, bool sendFrequently = true);
int readScreenRotation();
bool refreshAnnouncements();
bool refreshHours();
void calculateClosingEpochForToday();
void updateClosingMessageOfTheDay();

void handleOtaProgress(int offset, int totallength);
const char *getOtaErrorText(int code);
uint64_t millis64();
void connectNetwork();
#if CORE_HAS_ETHERNET
bool initializeEthernet();
String getEthernetMacAddress();
#endif
String getActiveNetworkInterface();
void publishMqttstatusMessage(String topic, String payload);
String getBaseMacAddress();
void sendStartupstatusMessage(String message);
String calculateSha256(String input);

// Shared objects.
#ifndef MEMORY_DIAG
#define MEMORY_DIAG 0
#endif
#if MEMORY_DIAG
void printMemoryReport(const char *tag);
void runMemoryDiagLoop(void *pvParameters);
#define MEM_CHECKPOINT(tag) printMemoryReport(tag)
#else
#define MEM_CHECKPOINT(tag)
#endif
extern ESPConfig config;
extern Preferences settings;
extern JsonDocument ConfigJson;
extern ESP32OTAPull ota;
extern ESP32Time rtc;
extern WebSocketsClient socket;
extern MQTTPubSub::PubSubClient<1536> mqtt;
extern OneWire ds;
#if CORE_HAS_LOCAL_AUDIO_VISUAL
extern Adafruit_NeoPixel CBI;
#endif
#if CORE_HAS_ACCELEROMETER
extern SPARKFUN_LIS2DH12 accel;
#endif
extern NetworkClientSecure networkclient;
#if !CORE_HAS_LOCAL_AUDIO_VISUAL
extern HardwareSerial frontend;
void frontendSend(const String &line); //Thread-safe; use instead of writing to frontend directly
extern bool frontendButtonPressed;
extern bool frontendCardDetect1;
extern bool frontendCardDetect2;
#endif
extern String rootCertificate;
extern bool gamerMode;
extern SystemState systemState;
extern bool accessEnabled;
extern bool faultBeepRequested;
extern int MakerspaceNumber;
extern String hardwareVersion;
extern bool identifyRequested;
extern String defaultInputMode;
extern NetworkState networkState;
extern volatile uint8_t lastDisconnectReason;
extern String lastDisconnectReasonVerbose;
extern unsigned long long lastReconnectTime;
extern KeepAlivePing keepAlivePing;
extern String serialNumber;
extern NetworkConfiguration networkConfiguration;
extern int makerspaceId;
extern MqttState mqttState;
extern Device sensorList[10];
extern bool configOneWire;
extern bool sealBroken;
extern bool reSealBus;
extern bool overTemp;
extern byte liveAddresses[5][8];
extern int liveAddressCount;
extern byte deviceCount;
extern byte redLed;
extern byte greenLed;
extern byte blueLed;
extern unsigned int buzzerTone;
extern bool resetLed;
extern bool unlockedBeep;
extern bool singleBeep;
extern ChannelSettings channelSettings;
extern String systemNotice; //Non-access message for the display; never affects channel state
extern String interruptResponse;
extern bool updateScreen;
extern String hmiMachineNames[4];
extern String hmiMakerspace;
extern String hmiDeviceName;
extern String hmiRole;
extern String stationName;
