MakeACS/HW-NFC-Core/(commit log)

2026-07-11 Increase 5v reg to 5.12v
2026-08-15 Rebase code to PIOArduino
    [ConfigurationController.h, core_v2_min_spiffs.csv, core_v3_8mb_spiffs.csv]
2026-08-16 fix swapped rx tx pins
    [MainController.cpp]
2026-08-17 Better logic for GPIO switching
2026-08-17 Fix memory allocation for OTA
    [MainController.cpp]
2026-08-20 Add reset reason monitoring and reporting
    [AudioVisualController.cpp, MainController.cpp]
2026-08-23 add CBI mount hole
2026-09-06 Implementing settings, network and MakeACS done
    [ConfigurationController.h]
2026-09-06 server-assigned device name
2026-09-28 Network timeout, hours fix
    [DisplayController.cpp]
2026-09-29 More aggressive network reset
    [AudioVisualController.cpp, helperFunctions.cpp]
2026-10-20 updated solder nuts
